cillian64/thegrid/hardware/README.md

# The·Grid Hardware

PCB designs for the power switching boards, the pole boards, and the bus driver 
board.
