cillian64/thegrid/website/content/blog/sticky.md

Date: 2014-07-05
Title: Welcome
Pin: true

The·Grid is an art/engineering installation to be displayed at 
[EMF](http://www.emfcamp.org) 2014 and 2016.  Visit the
[About]({filename}/pages/about.md) page for a quick overview of what we're
doing, or read the build log below for progress updates and juicy details...
