cillian64/thegrid/website/content/blog/2014-08-15.md

Title: Busy
Author: David
Tags: Electronics, cable, lasers

I've been extraordinarily busy!  First, I've finished filling all the PCBs,
shown here in the flight case with my Arduino Leonardo clone, the spare PCB and
the prototype PCB:

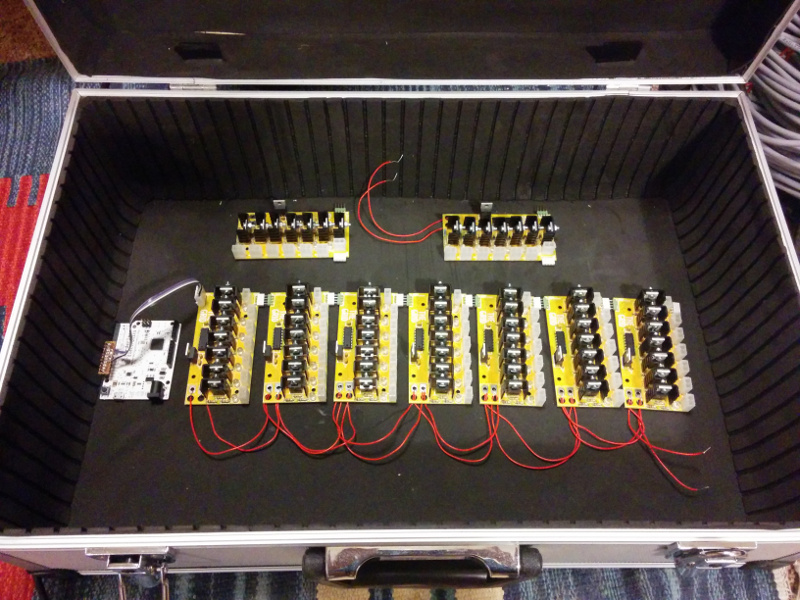
[picture p8: website/content/images/pcbs.jpg]
pcbs


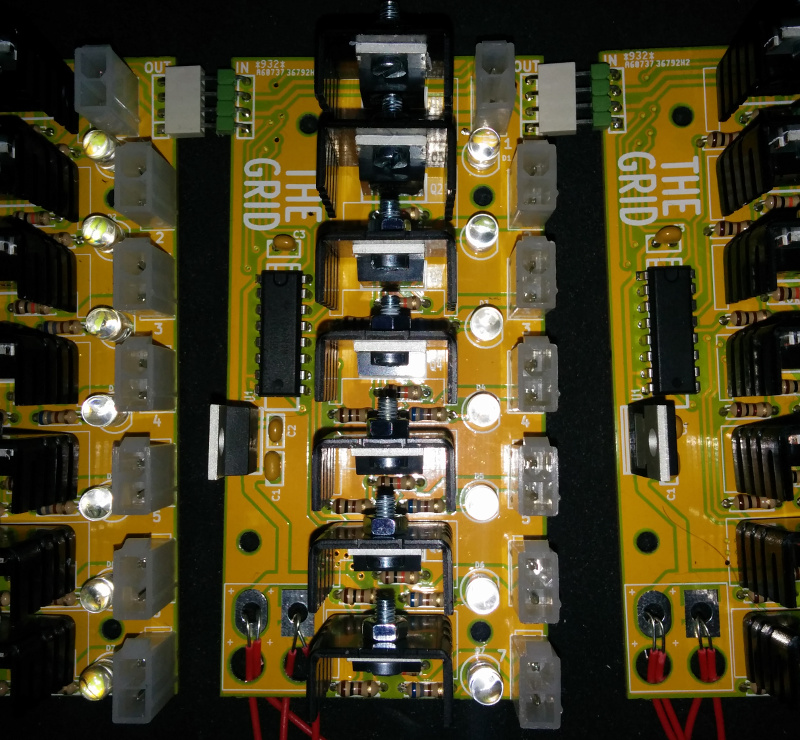
[picture p9: website/content/images/pcb.jpg]
pcb


More recently, I laser cut some beautiful rings to assist with guying of the
camera mast:

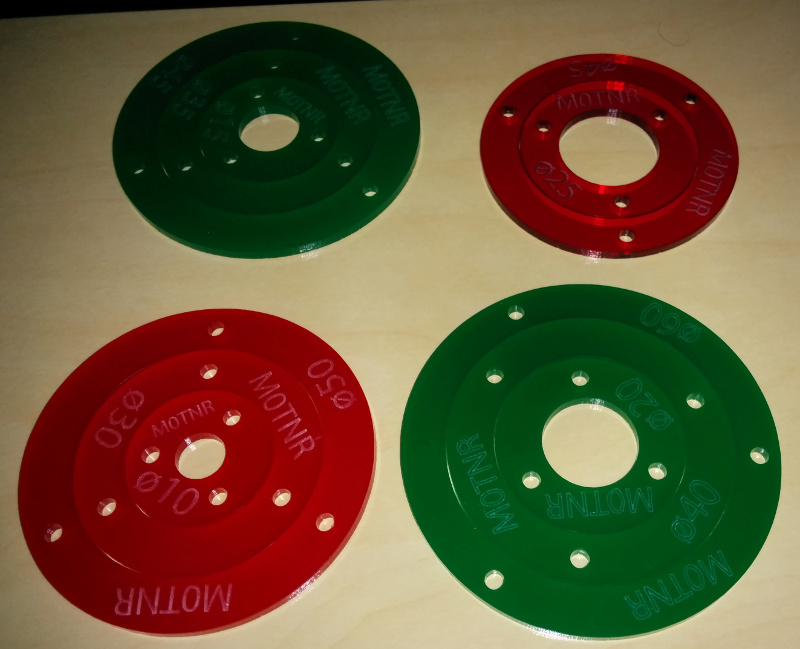
[picture p10: website/content/images/guying_rings.jpg]
guying rings


I also finished cutting all the cable into correct lengths:

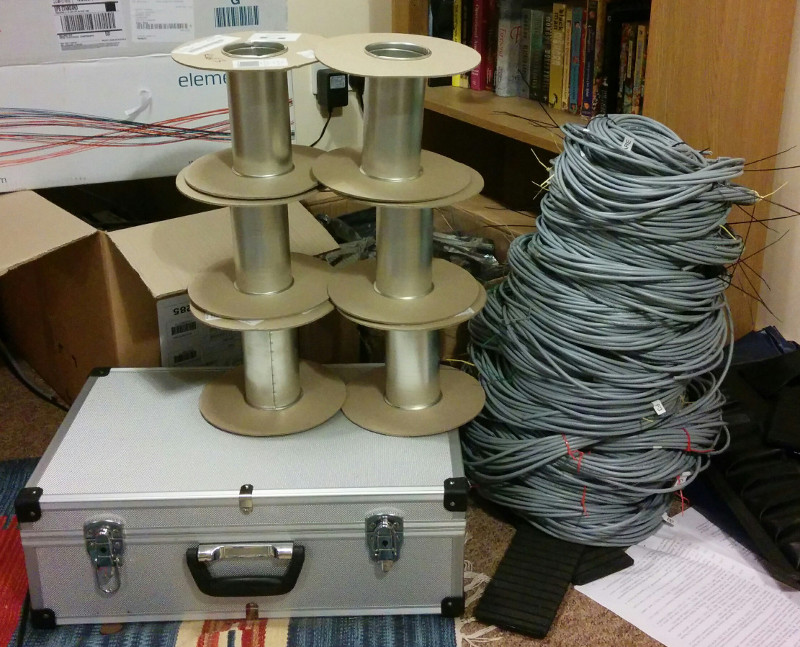
[picture p11: website/content/images/lots_cable.jpg]
lots of cable


Hopefully tomorrow we'll be getting started on the computer vision code...
