cillian64/thegrid/website/content/blog/2014-08-04.md

Title: Wire Delivery
Date: 2014-08-04
Author: Adam
Tags: electronics

Today we got the rest of the PCB components, the flight case that will house
the electronics, and the first 400m of field cable from CPC:

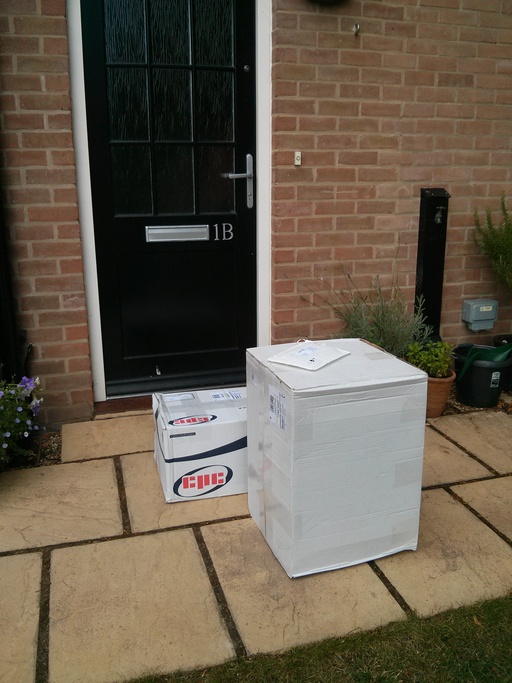
[picture p13: website/content/images/wire_delivery.jpg]
wire delivery


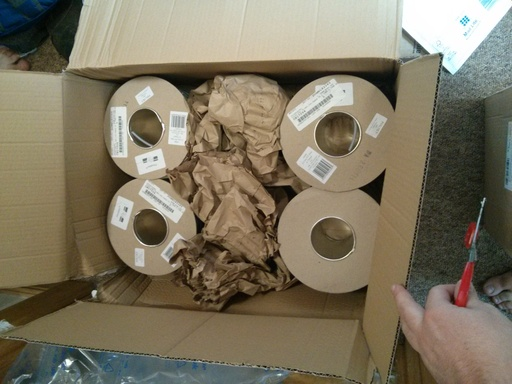
[picture p14: website/content/images/wire_spools.jpg]
wire spools


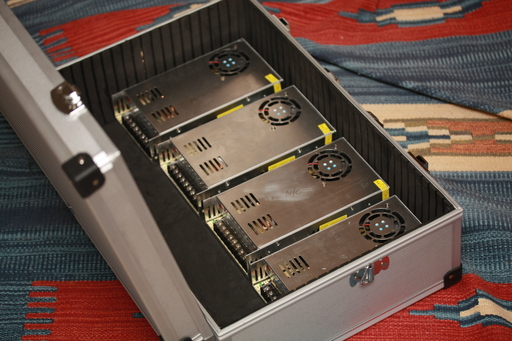
[picture p15: website/content/images/psus_in_case_mock.jpg]
psus in flight case


Looking good! We'll get the rest of the PCBs soldered up over the next few days
and then all that's left is a little mechanical work and a lot of careful
software.
