cillian64/thegrid/website/content/blog/2014-07-25.md

Title: PCBs!!!
Date: 2014-07-25
Tags: Electronics
Author: David

The PCBs arrived!  They are looking beautiful in yellow silk with shiny HASL
finish.  Considering how much Dirty PCBs downplay their quality, these boards
are excellent.  I can't fault anything on the copper, and the soldermask looks
great.  Registration isn't amazing on the drill hits and silk, but it's still
very good.  The silk is iffy in places, but that was expected.  Now all we have
to do is wait for the full complement of components.

Thanks to [Dirty PCBs](http://dirtypcbs.com/) for excellent service and
excellent boards -- we'll be back for our next project!

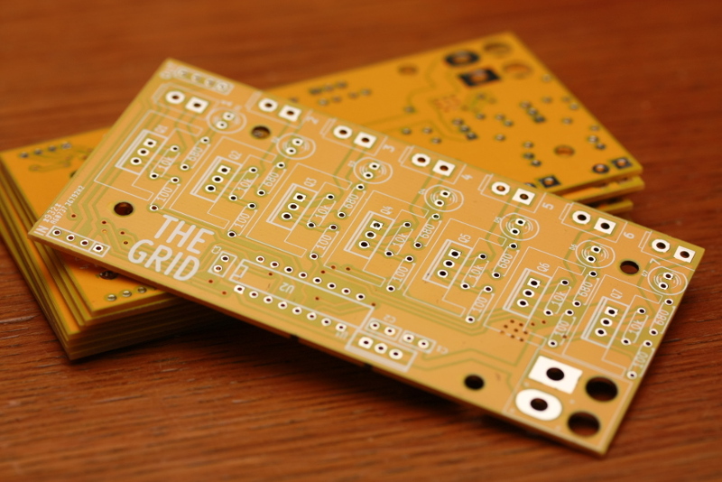
[picture p21: website/content/images/pcb_stack.jpg]
pcb stack


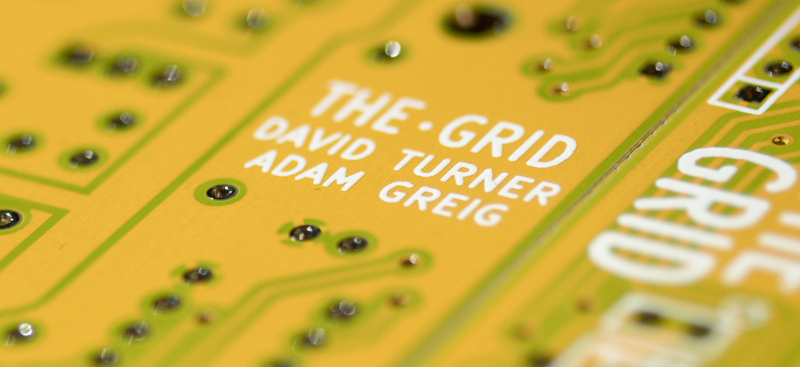
[picture p22: website/content/images/pcb_silk.jpg]
pcb silk


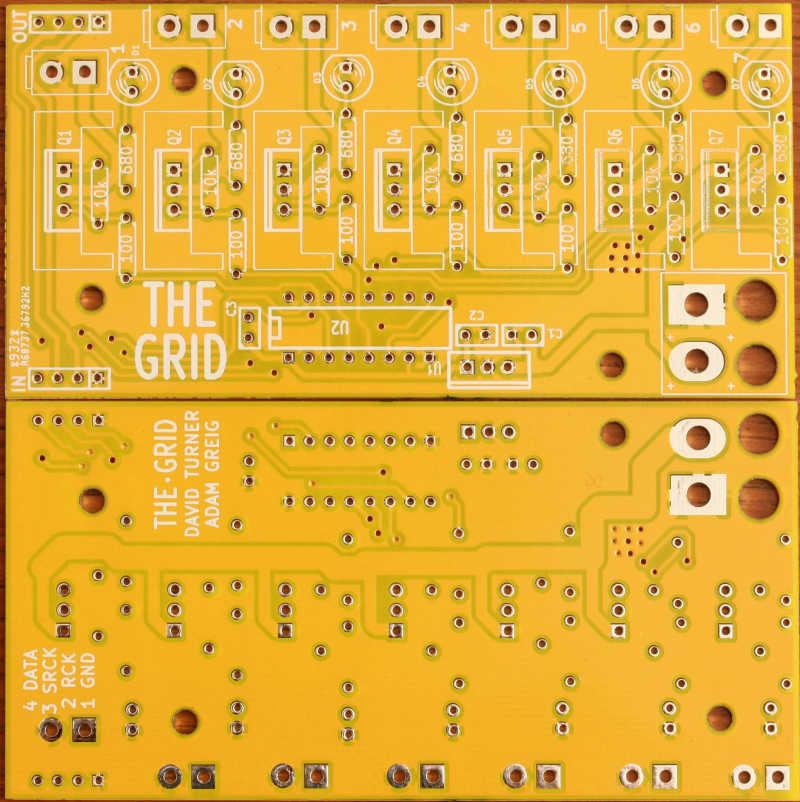
[picture p23: website/content/images/pcb_two.png]
pcb clear
