cillian64/thegrid/website/content/blog/2014-07-16-2.md

Title: Yellow PCB
Author: David
Tags: Electronics

I'm really excited about the PCBs, but don't really have much to report.
They're with fab house and should be manufactured by the beginning of next week
and with us by the end of next week.  Before they went to fab, I made a few
minor changes, mainly to increase clearance and track width.  This should make
the board pretty hard to get wrong, meaning we get a good yield.

Here are the updated gerbers, rendered by [Dirty PCBs](http://dirtypcbs.com/)
in a rendition of their final yellow soldermask:

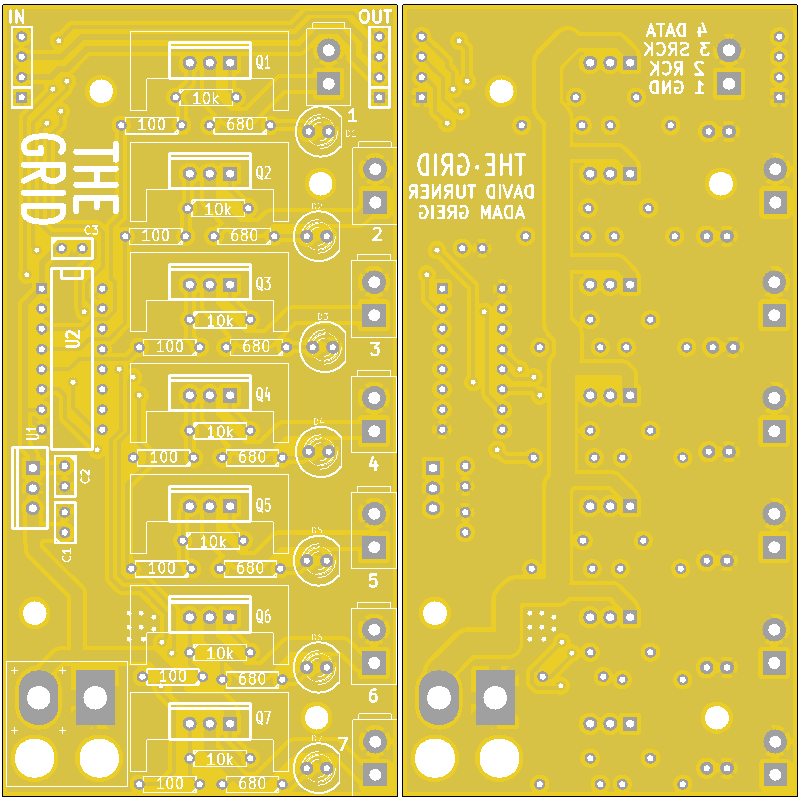
[picture p24: website/content/images/pcb_yellow.png]
yellow pcbs
