cillian64/thegrid/website/content/blog/2014-07-13.md

Title: Testing Intensifies
Tags: electronics, software
Date: 2014-07-13
Author: Adam

Another busy day. Further software refinements led to a Tkinter-based sink to
make visualisation easier:

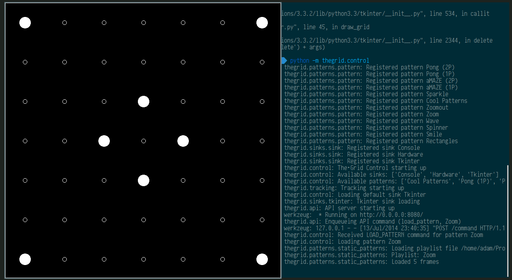
[picture p25: website/content/images/tkinter.png]
Tkinter GUI


I also stuck together a simple sink using pylibftdi in bitbang mode, which was
even easier than I expected. It generates the DATA, SRCK and RCK signals for
the shift registers using three pins on the FTDI.

Meanwhile David was busy finishing up the PCB design (more on that later).
Afterwards he stuck together the prototype electronics on a breadboard,
connected up the relays and two (of the eventual 49) LED strips and we tried
hooking it all up for the first time.

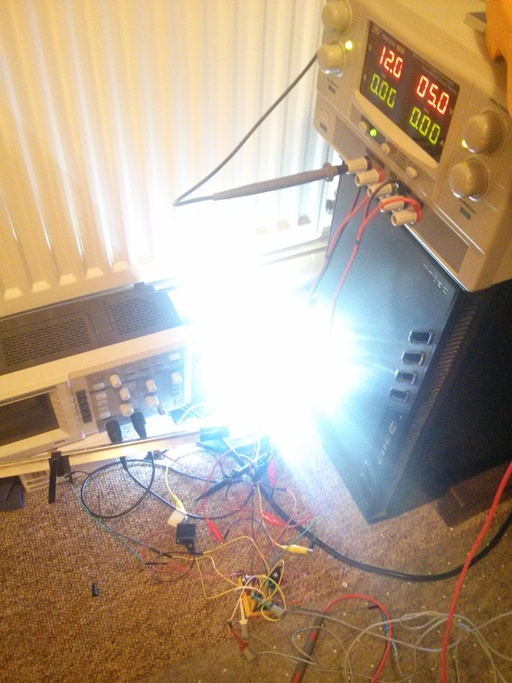
[picture p26: website/content/images/first_full_test.jpg]
First Full Test

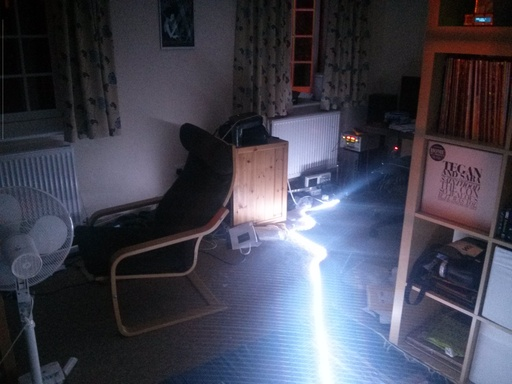
[picture p27: website/content/images/full_test_unrolled.jpg]
Full Test Unrolled


<iframe width="420" height="315"
src="//www.youtube-nocookie.com/embed/3Ok0Z6Nax6U?rel=0" frameborder="0"
allowfullscreen></iframe>

It all worked! Additionally the relays sounded great on one of the aluminium
poles. This is a very positive result and we're now confident that the
electronics design, software design, and various other choices that led to this
moment were at least on the right track.  All that's left is the actual PCBs,
the hard parts of the software (person tracking!) and a million other
tasks-to-do before EMF.
