cillian64/thegrid/website/content/blog/2014-07-13_2.md

Title: Gerbils away!
Date: 2014-07-13
Tags: Electronics
Author: David

After a final slog, the PCB was routed and ready to go!  Less than 48 hours
from deciding to do a PCB to submitting Gerbers has got to be a record.

I'll try to talk some more about some of the design choices when I've had more
sleep.  For now, here's what it looks like:

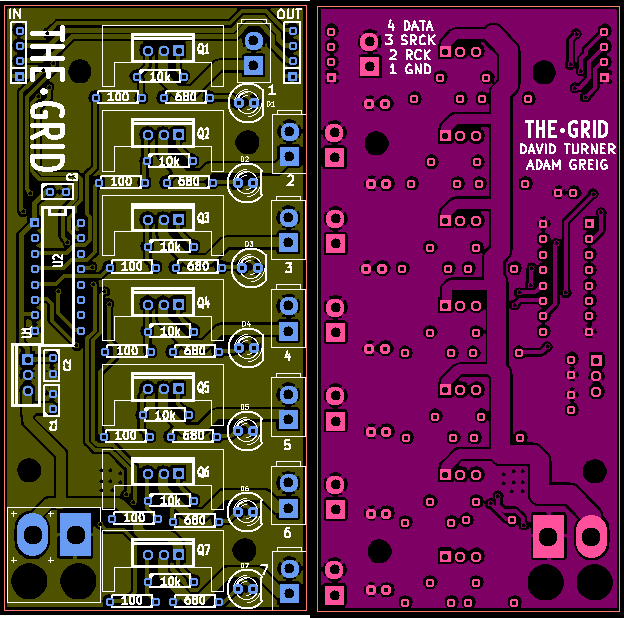
[picture p28: website/content/images/gerbils.png]
Gerbils...


And now, their fate rests in the trustworthy hands of [Dirty
PCBs](http://dirtypcbs.com/)...

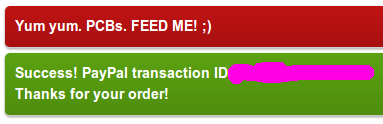
[picture p29: website/content/images/yum_yum_pcbs.png]
Ruh roh
