cillian64/thegrid/website/content/blog/2014-07-16.md

Title: LEDs Arrived!
Author: Adam
Date: 2014-07-16
Tags: LEDs

The LEDs turned up! £300, 250m, 7500 LEDs, in one unassuming box:

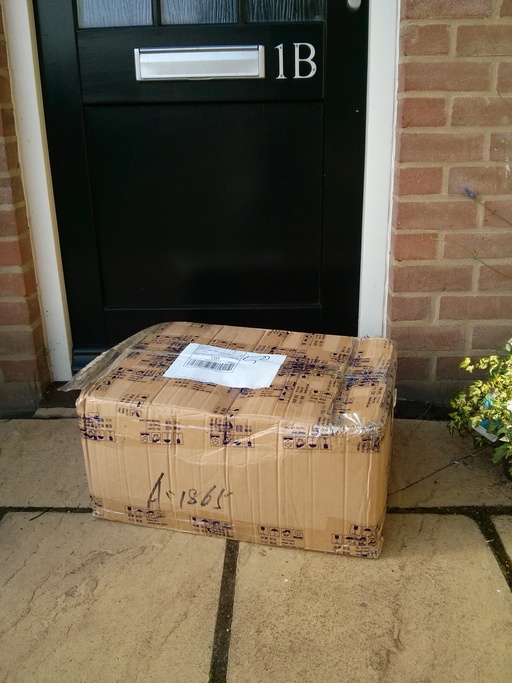
[picture p30: website/content/images/led_parcel.jpg]
LED parcel


We opened it up, and sure enough, 50 individually bagged reels of 5m LED strip:

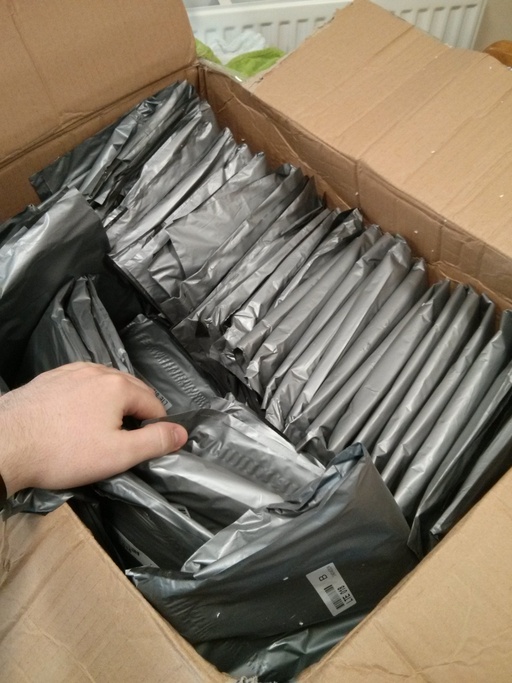
[picture p31: website/content/images/led_opened.jpg]
LED strips


Obviously we had to test all 50 to be sure they were in fine working order, so
we sat down and got to it.

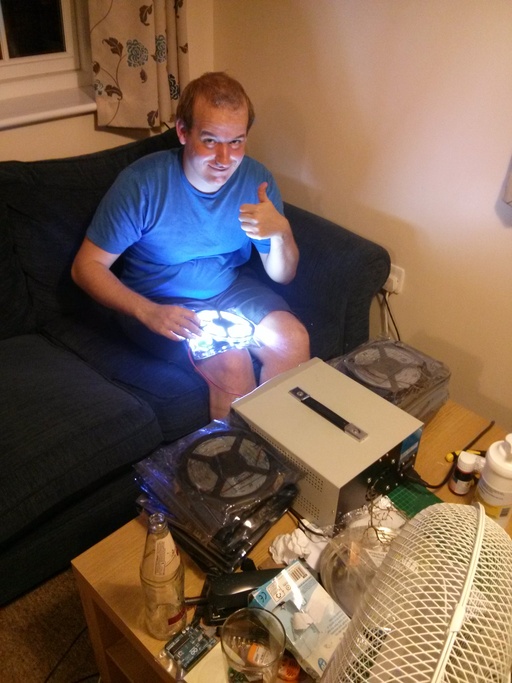
[picture p32: website/content/images/led_testing.jpg]
LED testing


I'm happy to report that every LED functioned correctly. Hurray!
