cillian64/thegrid/website/content/blog/2014-07-11.md

Title: Testing LED strips and a PSU
Tags: electronics, power, testing
Author: David
Date: 2014-07-11

I received a lot of parcels today!  The LEDs, thermal compound, some relays,
and what we have affectionately termed The Danger Cable:

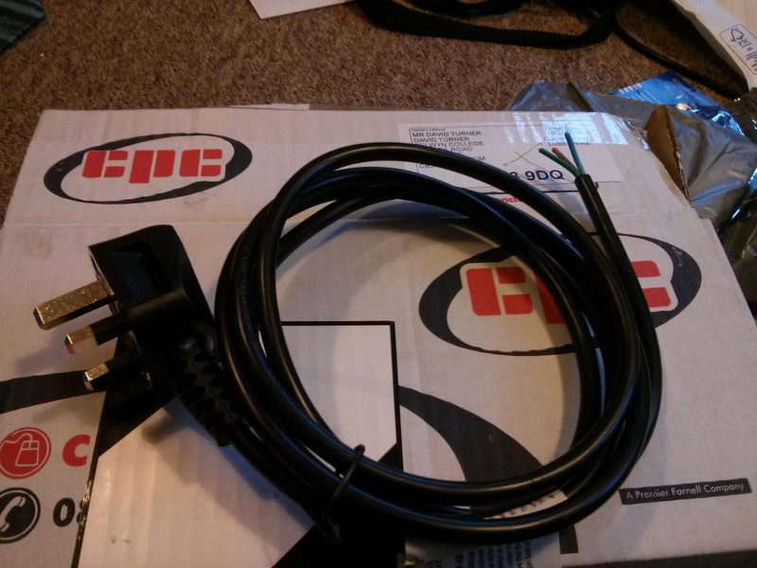
[picture p33: website/content/images/danger_cable.jpg]
schematic


At first we weren't convinced the LED strips would be bright enough.  A quick
test in the garden cleared any doubts about the brightness:

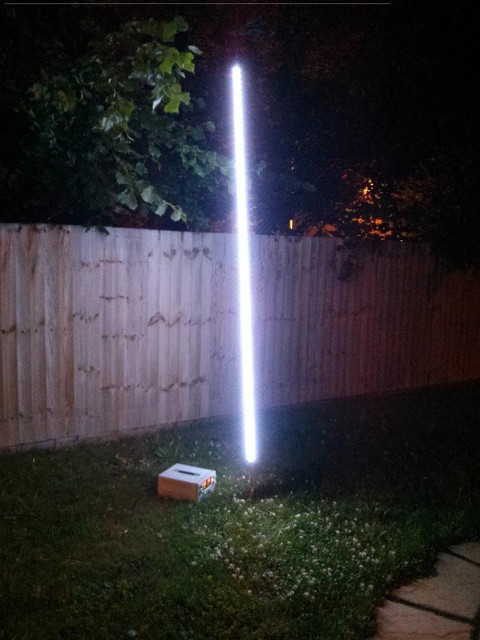
[picture p34: website/content/images/lightsabre.jpg]
lightsabre


Finally, I finished putting the power supply back together after a good clean
and a fresh dab of thermal grease.  After a little sanity testing, we thought
we'd give it some load:

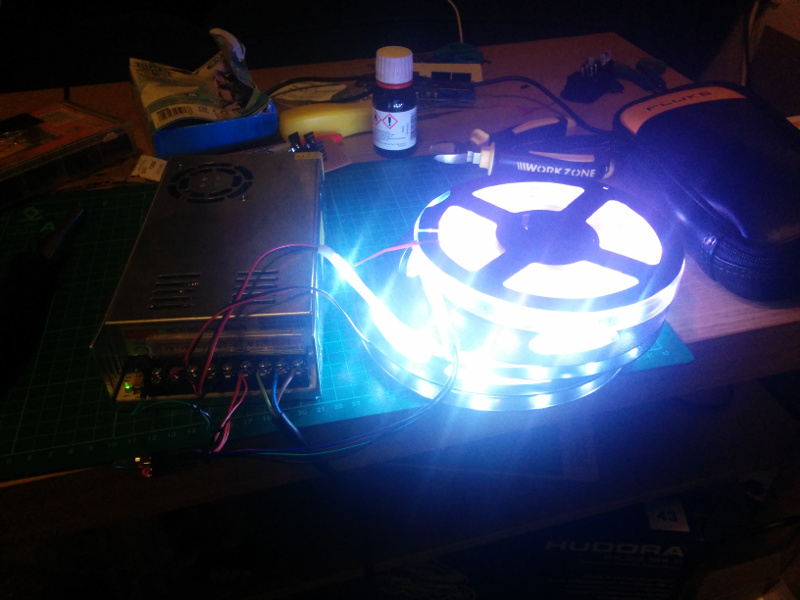
[picture p35: website/content/images/psu_test.jpg]
power supply testing


The power supply seems to work beautifully, although it was only pushing 4A out
of its rated 30A!
