cillian64/thegrid/website/content/blog/2014-07-09.md

Title: Aluminium Arrived (at last)
Tags: structures, power
Author: Adam
Date: 2014-07-09

After some more wrangling with the online vehicle tracking, we eventually had a
firm ETA... in the past. It slipped slowly further back in time until the
estimated delivery was an hour ago.

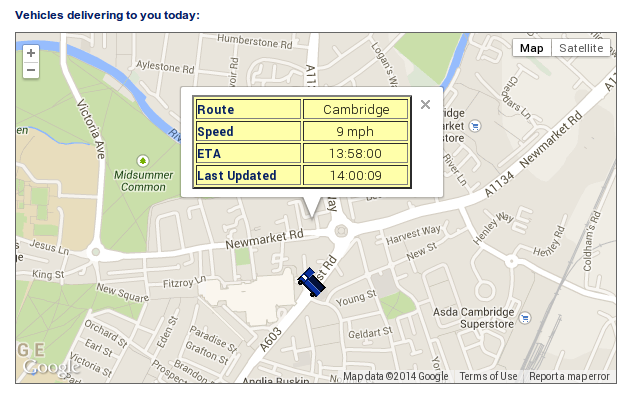
[picture p39: website/content/images/eta_the_past.png]
delivery tracking...


Luckily the aluminium did eventually make it to the present time and we happily
took delivery.

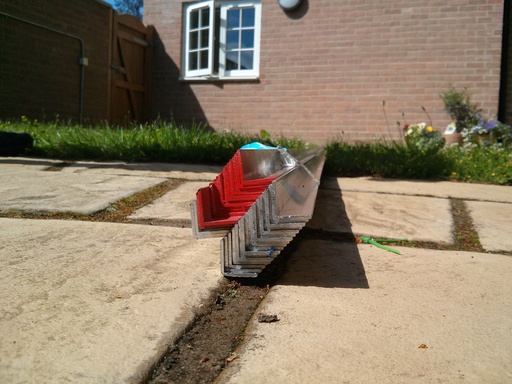
[picture p40: website/content/images/alu_in_garden.jpg]
aluminium in the garden


A few hours of hard sawing, filing and taping up later, and we now have eight
bundles of aluminium angle, all ready to be used for the structural component
of TheGrid.

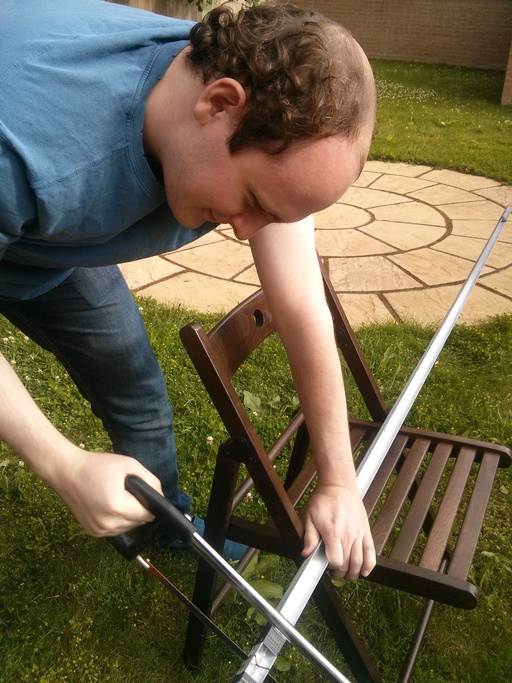
[picture p41: website/content/images/adam_sawing.jpg]
adam sawing


We also opened up one of the power supplies to investigate the design and
quality. True to the "Professional" sticker on the box, the insides included a
large toroid that had torn free of its soldering, so we'll probably need to do
a little rework before these are shipshape.

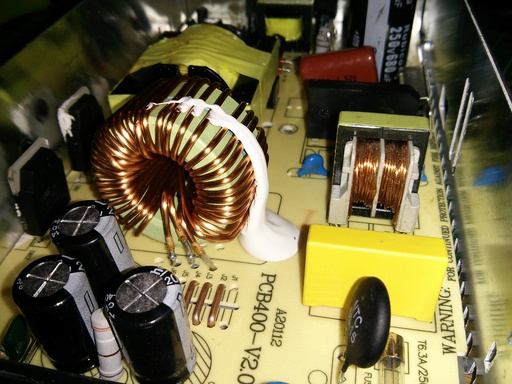
[picture p42: website/content/images/psu_dodgy_transformer.jpg]
i'm sure this PSU is just fine


The rest of the prototype electronics have also arrived, so we're ready to
start testing the control electronics. Hopefully the first LEDs (to verify
colour choice) will be arriving tomorrow so we can light something up!
