cillian64/thegrid/website/content/blog/2014-07-08.md

Title: PSUs arrived (aluminium didn't)
Tags: power
Date: 2014-07-08
Author: Adam

Five of the most legitimate 30A 12V PSUs you can find on eBay arrived today:
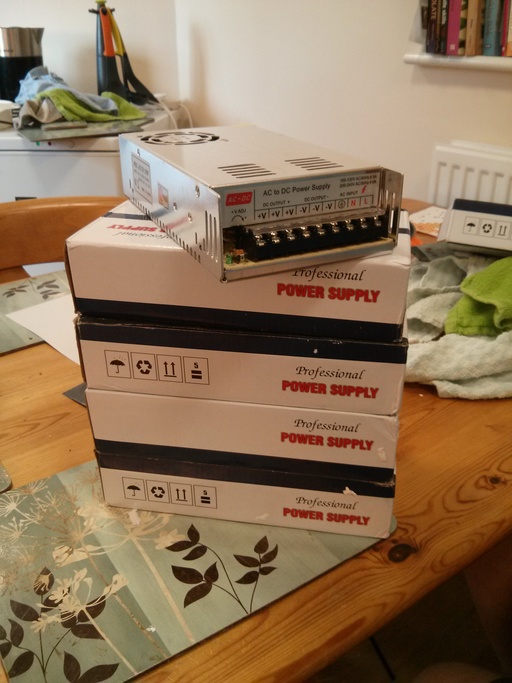
[picture p43: website/content/images/psus_arrived.jpg]
PSUs arrived


Unfortunately the aluminium couldn't be delivered today so fingers crossed
we'll get it tomorrow.
