cillian64/thegrid/website/content/blog/2014-07-05.md

Title: Approval!
Date: 2014-07-05
Author: David
Tags: power

We got approval!  We've been waiting for the EMF committee to get back to us
about our proposal, and, they did -- The·Grid at EMF2014 is happening!

To celebrate, I bought £70 worth of 12V PSUs (150A worth) and we set up this
website.
