cillian64/thegrid/misc/scripts/cutting_list.odt

--== CUTTING LIST ==--

THE.GRID 2

SERIAL CABLES

--- Reel 1 ---

9.2m [ ]

9.2m [ ]

9.2m [ ]

7.2m [ ]

7.2m [ ]

5.2m [ ]

5.2m [ ]

3.2m [ ]

3.2m [ ]

3.2m [ ]

3.2m [ ]

3.2m [ ]

3.2m [ ]

3.2m [ ]

3.2m [ ]

3.2m [ ]

3.2m [ ]

3.2m [ ]

3.2m [ ]

3.2m [ ]

3.2m [ ]

Leftover: 2.8m

Cable Tie Colours:

3.2m: purple

5.2m: yellow

7.2m: orange

9.2m: red

other/spare: black

--- Reel 2 ---

3.2m [ ]

3.2m [ ]

3.2m [ ]

3.2m [ ]

3.2m [ ]

3.2m [ ]

3.2m [ ]

3.2m [ ]

3.2m [ ]

3.2m [ ]

3.2m [ ]

3.2m [ ]

3.2m [ ]

3.2m [ ]

3.2m [ ]

3.2m [ ]

3.2m [ ]

3.2m [ ]

3.2m [ ]

3.2m [ ]

3.2m [ ]

3.2m [ ]

3.2m [ ]

3.2m [ ]

3.2m [ ]

3.2m [ ]

3.2m [ ]

3.2m [ ]

3.2m [ ]

3.2m [ ]

Leftover: 4.0m
