cillian64/thegrid/misc/docs/proposal/diags/plan.png

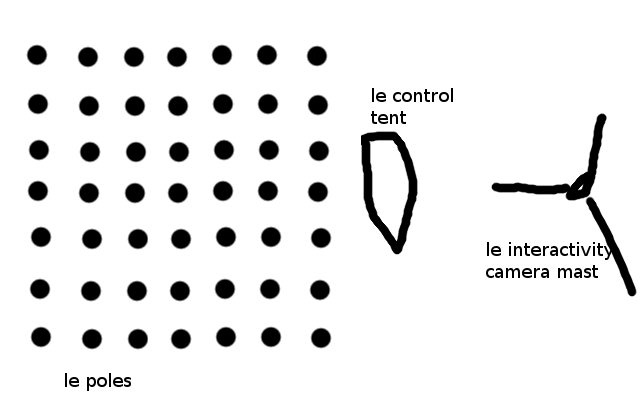
misc/docs/proposal/diags/plan.png
