cillian64/thegrid/misc/docs/proposal/diags/sidepole.png

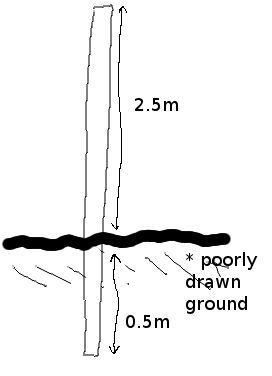
misc/docs/proposal/diags/sidepole.png
