cillian64/thegrid/misc/docs/proposal/diags/toppole.png

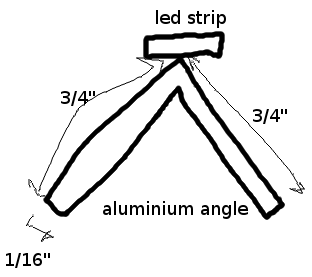
misc/docs/proposal/diags/toppole.png
