cillian64/thegrid/misc/docs/proposal_2/pics/thegrid_at_emf14_3.jpg

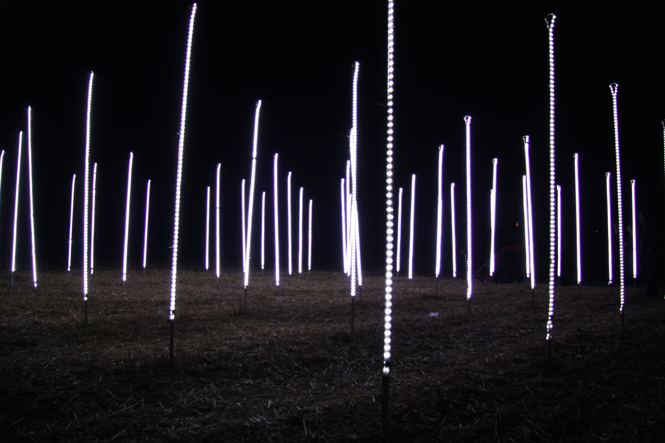
misc/docs/proposal_2/pics/thegrid_at_emf14_3.jpg
