cillian64/thegrid/misc/docs/farnell_parts.ods

Premier Farnell Sponsorship
Order # | Item | Quantity | Cost EA | Cost
1712122 | DURATOOL - TC-1 - ALUMINIUM TOOL CASE | 1 | £34.51 | 34.51
9846557 | FAIRCHILD SEMICONDUCTOR - FQP7P06 - MOSFET, P, TO-220 | 55 | £0.67 | 36.85
9339051 | MULTICOMP - MCF 0.25W 1K - RESISTOR, CARBON FILM, 1K, 0.25W, 5% | 50 | £0.02 | 1.05
1611415 | AAVID THERMALLOY - 507302B00000G - HEATSINK, TO-220, 24°C/W | 55 | £0.23 | 12.815
1470497 | TEXAS INSTRUMENTS - TPIC6C595N - IC, 8BIT SHIFT REGISTER | 10 | £1.33 | 13.3
2335729 | KINGBRIGHT - L-1503EC - LED, 5MM, RED, 50MCD, 617NM | 55 | £0.06 | 3.3
9338926 | MULTICOMP - MCF 0.5W 680R - RESISTOR, 0.5W 5% 680R | 50 | £0.02 | 0.85
1333039 | PRO POWER - 2192Y-0.75MMWHT100M - CABLE, FLEX, 2192Y, WHITE, 0.75MM, 100M | 6 | £32.58 | 195.48
1179199 | PRO POWER - 1179199 - WIRE, BK, BS6231, YELLOW, 6MM, 25M | 1 | £19.18 | 19.18
9423230 | MULTICOMP - N254-899 - STRIPBOARD, SNGL SIDED, 0.1INCH | 2 | £15.21 | 30.42
1892001 | TE CONNECTIVITY / OEG - SDT-S-112LMR,000 - RELAY, PCB, SPST-NO, 12VDC, 10A | 50 | £0.55 | 27.4
 |  |  | Sum: | 375.155
Us
Order # | Description | Quantity | Cost EA | Cost
TLTC1 | Flight Case | 1 | £18.85 | £18.85
SC08203 | FQP7P06 | 55 | £0.21 | £11.28
1611415 | Heatsinks | 50 | £0.17 | £8.37
1470497 | Shift Registers | 10 | £0.73 | £7.27
2335729 | LEDs | 55 | £0.04 | £2.26
CB17113 | Chunky PSU cable | 5 | £0.73 | £3.65
1892001 | Relays | 50 | £0.45 | £22.47
CN18792 | Crimp pins | 100 | £0.02 | £2.46
CN18767 | Connector receptacles | 50 | £0.06 | £2.87
CN18779 | Connector headers | 50 | £0.11 | £5.33
 |  |  | Sum: | £74.14
 |  |  | +VAT: | £88.96
Cable from Discount Electrical |  | 6 | £14.90 | £116.28
 |  | Grand Total: |  | £205.24
