cillian64/thegrid/hardware/pole/bom.ods

Farnell # | Q to order | Q per pole | Description | Q per 57 | Spare/bonus
1830747 | 120 | 2 | BUS_OUT BUS_IN | 114 | -4
9330399 | 130 | 2 | 10k 0603 | 114 | 16
2496930 | 70 | 1 | 4u7 0603 | 57 | 13
2296040 | 60 | 1 | LD1117DT33CTR TO-252-3 | 57 | 0
2393639 | 58 | 1 | STM32F0xxKxUx QFN-32-EP-ST | 57 | 1
9330410 | 70 | 1 | 1M 0603 | 57 | 13
2494233 | 70 | 1 | 10u 0603 | 57 | 13
2342314 | 60 | 1 | LMx93 SOIC-8 | 57 | 3
2284077 | 240 | 4 | MTM232270LBF SOT-323 | 228 | 12
2496916 | 70 | 1 | 1u 0603 | 57 | 13
2496826 | 70 | 1 | 10n 0603 | 57 | 13
2496833 | 250 | 4 | 100n 0603 | 228 | 22
1823866 | 60 | 1 | SPEAKER piezo | 57 | 3
2329477 | 10 | 0 | 120R 1/4W Termination | 0 | 10
1700251 | 70 | 1 | 10k for piezo bodge | 57 | 13
