cillian64/thegrid/misc/laser/signs/element14.dxf

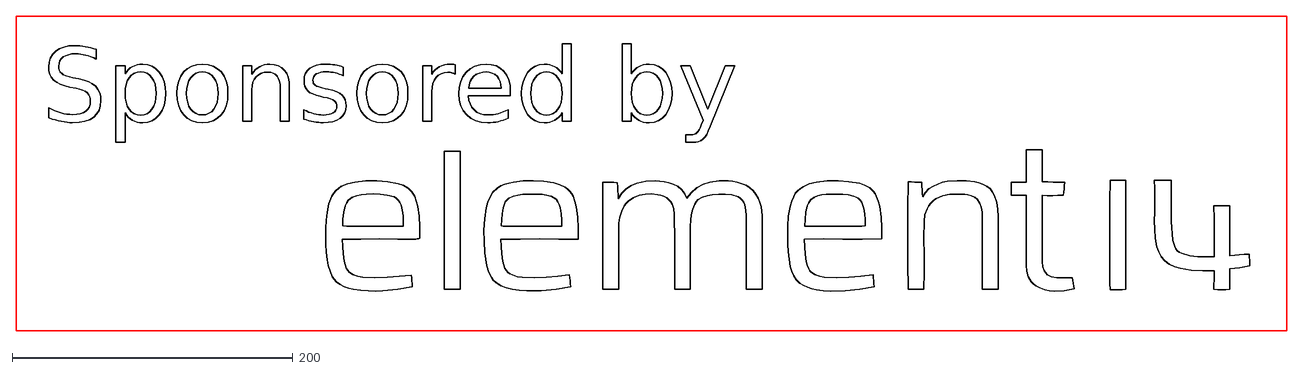
[picture p53: CAD file, 2014-08-26]
misc/laser/signs/element14.dxf
904.6 x 224.2
