cillian64/thegrid/misc/laser/guying_rings_stacked.dxf

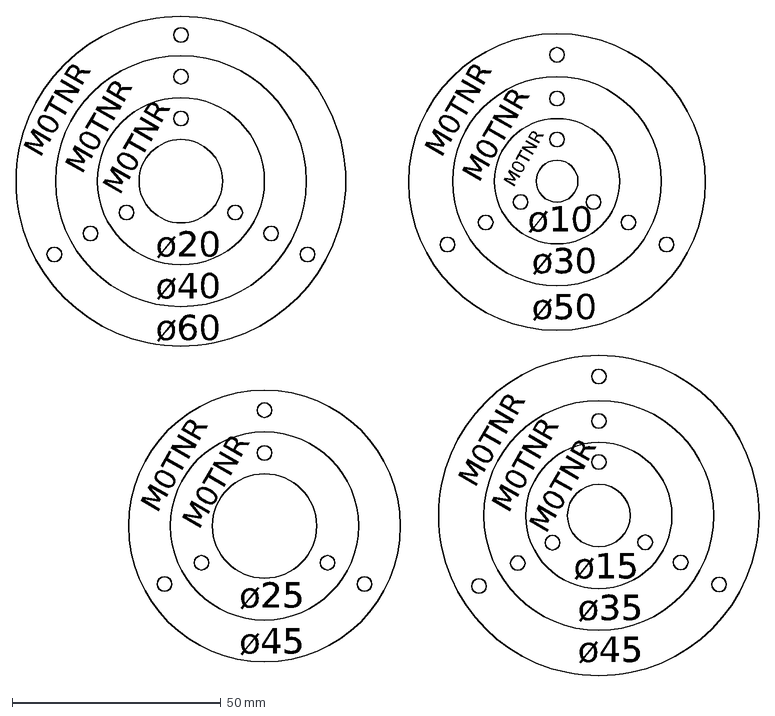
[picture p54: CAD file, 2014-08-16]
misc/laser/guying_rings_stacked.dxf
M0TNR
ø20
ø40
ø60
ø30
ø50
ø10
ø25
ø45
ø15
ø35
