cillian64/thegrid/misc/laser/signs/url.dxf

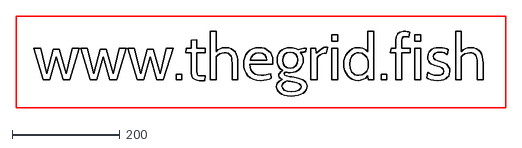
[picture p55: CAD file, 2014-08-26]
misc/laser/signs/url.dxf
906.6 x 169.6
