cillian64/thegrid/misc/laser/signs/both_signs_text_flattified.dxf

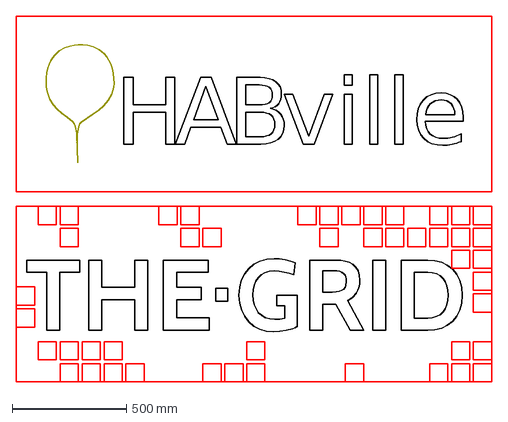
[picture p56: CAD file, 2014-08-22]
misc/laser/signs/both_signs_text_flattified.dxf
2080.0 x 1600.0 mm
