cillian64/thegrid/misc/laser/signs/noarduino.dxf

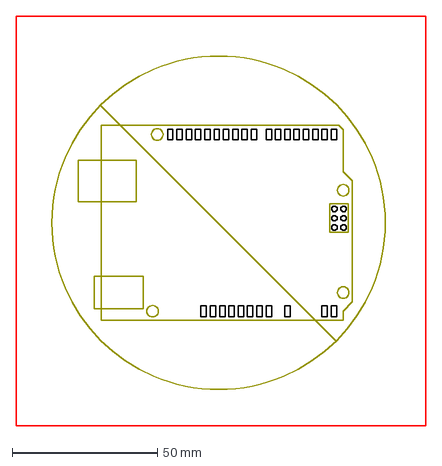
[picture p57: CAD file, 2014-08-22]
misc/laser/signs/noarduino.dxf
141.0 x 141.0 mm
