cillian64/thegrid/(list of files, cad)

Other CAD files:
misc/laser/all.dxf
