cillian64/thegrid/(threads)

Thread 16 (2016-04-13):

Manufacturing Checklist

adamgreig, 2016-04-13:
- [x] Make all serial cables
- [x] Make all power cables
- [x] Make all pole PCBs
- [x] Attach PCBs to LED strips

cillian64, 2016-04-13:
- [ ] make terminators

Closed 2019-11-08.

Thread 21 (2016-07-24):

Shield PCB r2

cillian64, 2016-07-24:
- [ ] Half the driver connectors are inverted relative to the part
 - [ ] Add an STM32F051 with USB instead of arduino shield
 - [ ] Bus drivers want a 5V supply, STM32 will want 3v3
