cillian64/thegrid/hardware/driver/shield_bom.pdf

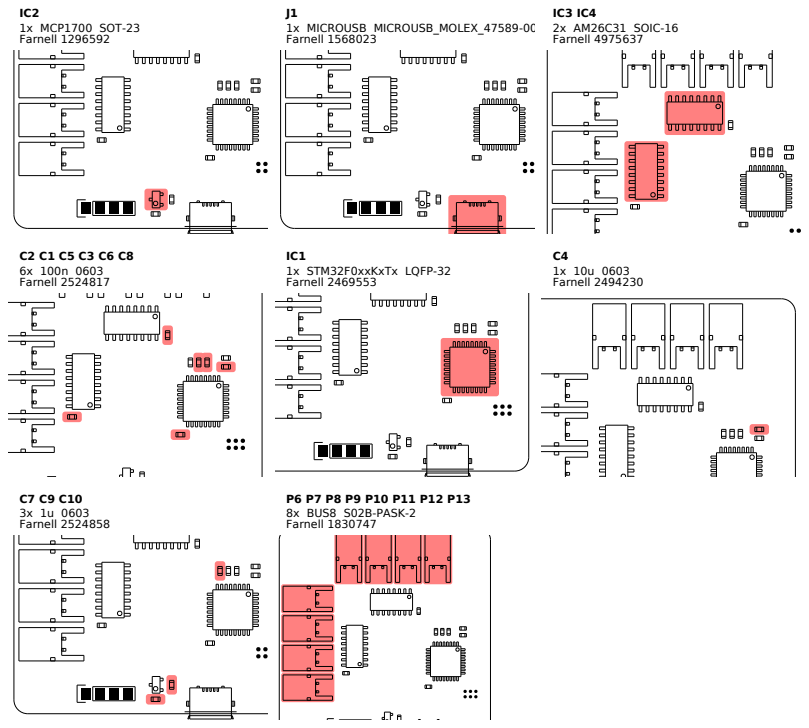
[picture p58: page 1]
