cillian64/thegrid/hardware/driver/shield.pdf

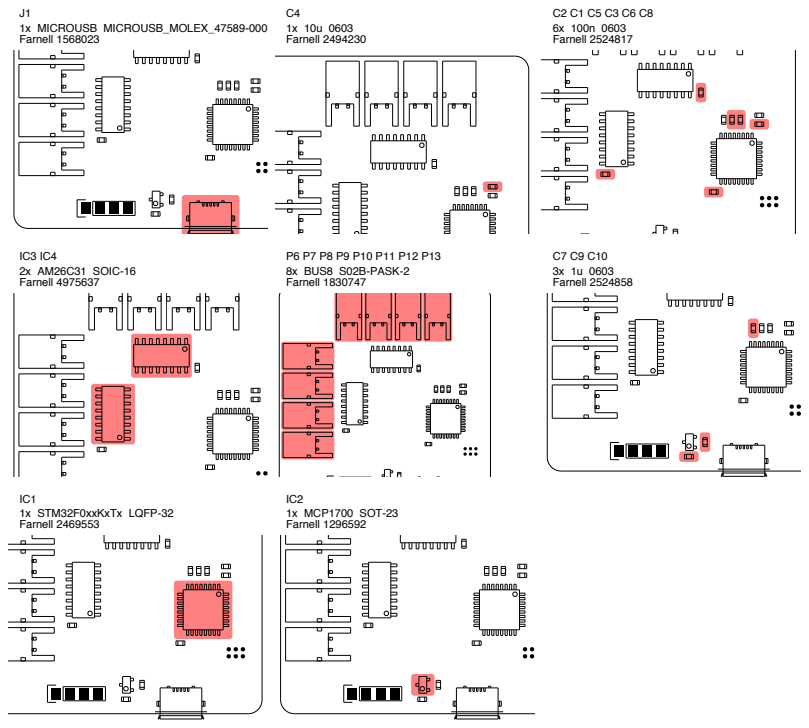
[picture p59: page 1]
