cillian64/thegrid/hardware/pole/pole.pdf

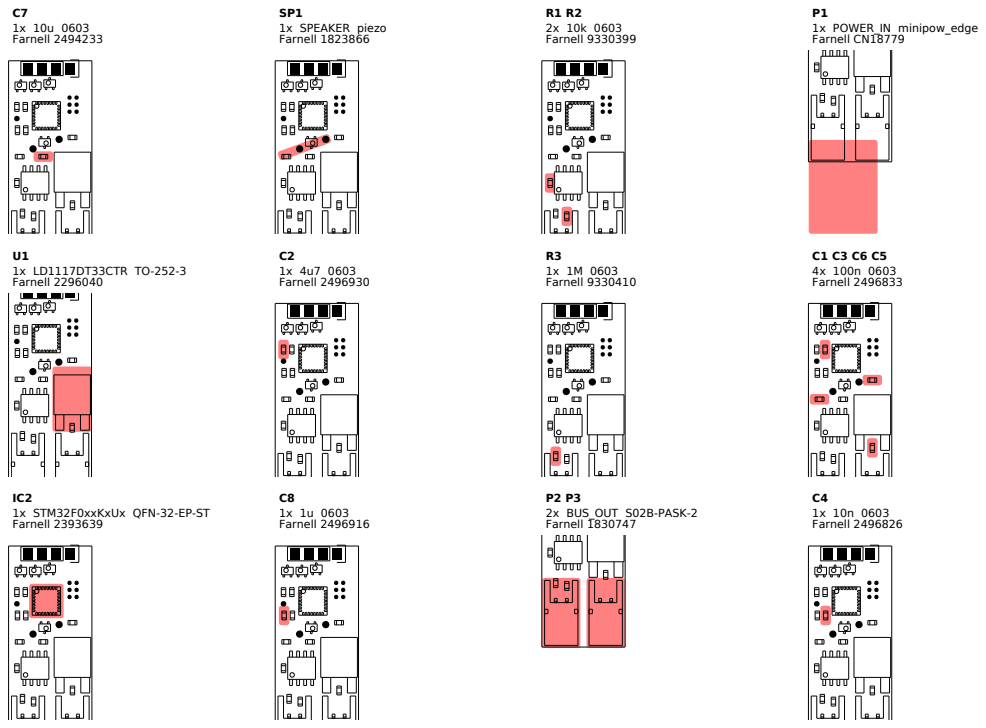
[picture p60: page 1]

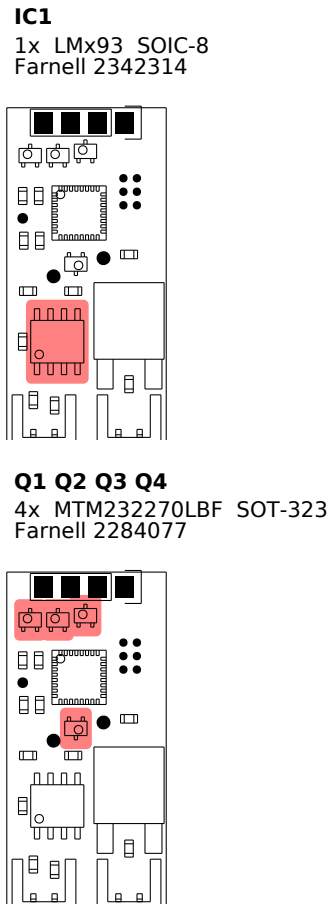
[picture p61: figure]
IC1 1x LMx93 SOIC-8 Farnell 2342314; Q1 Q2 Q3 Q4 4x MTM232270LBF SOT-323 Farnell 2284077
