cillian64/thegrid/hardware/driver/shield.kicad_pcb

## KiCad design hardware/driver/shield.kicad_pcb (2016-07-24)

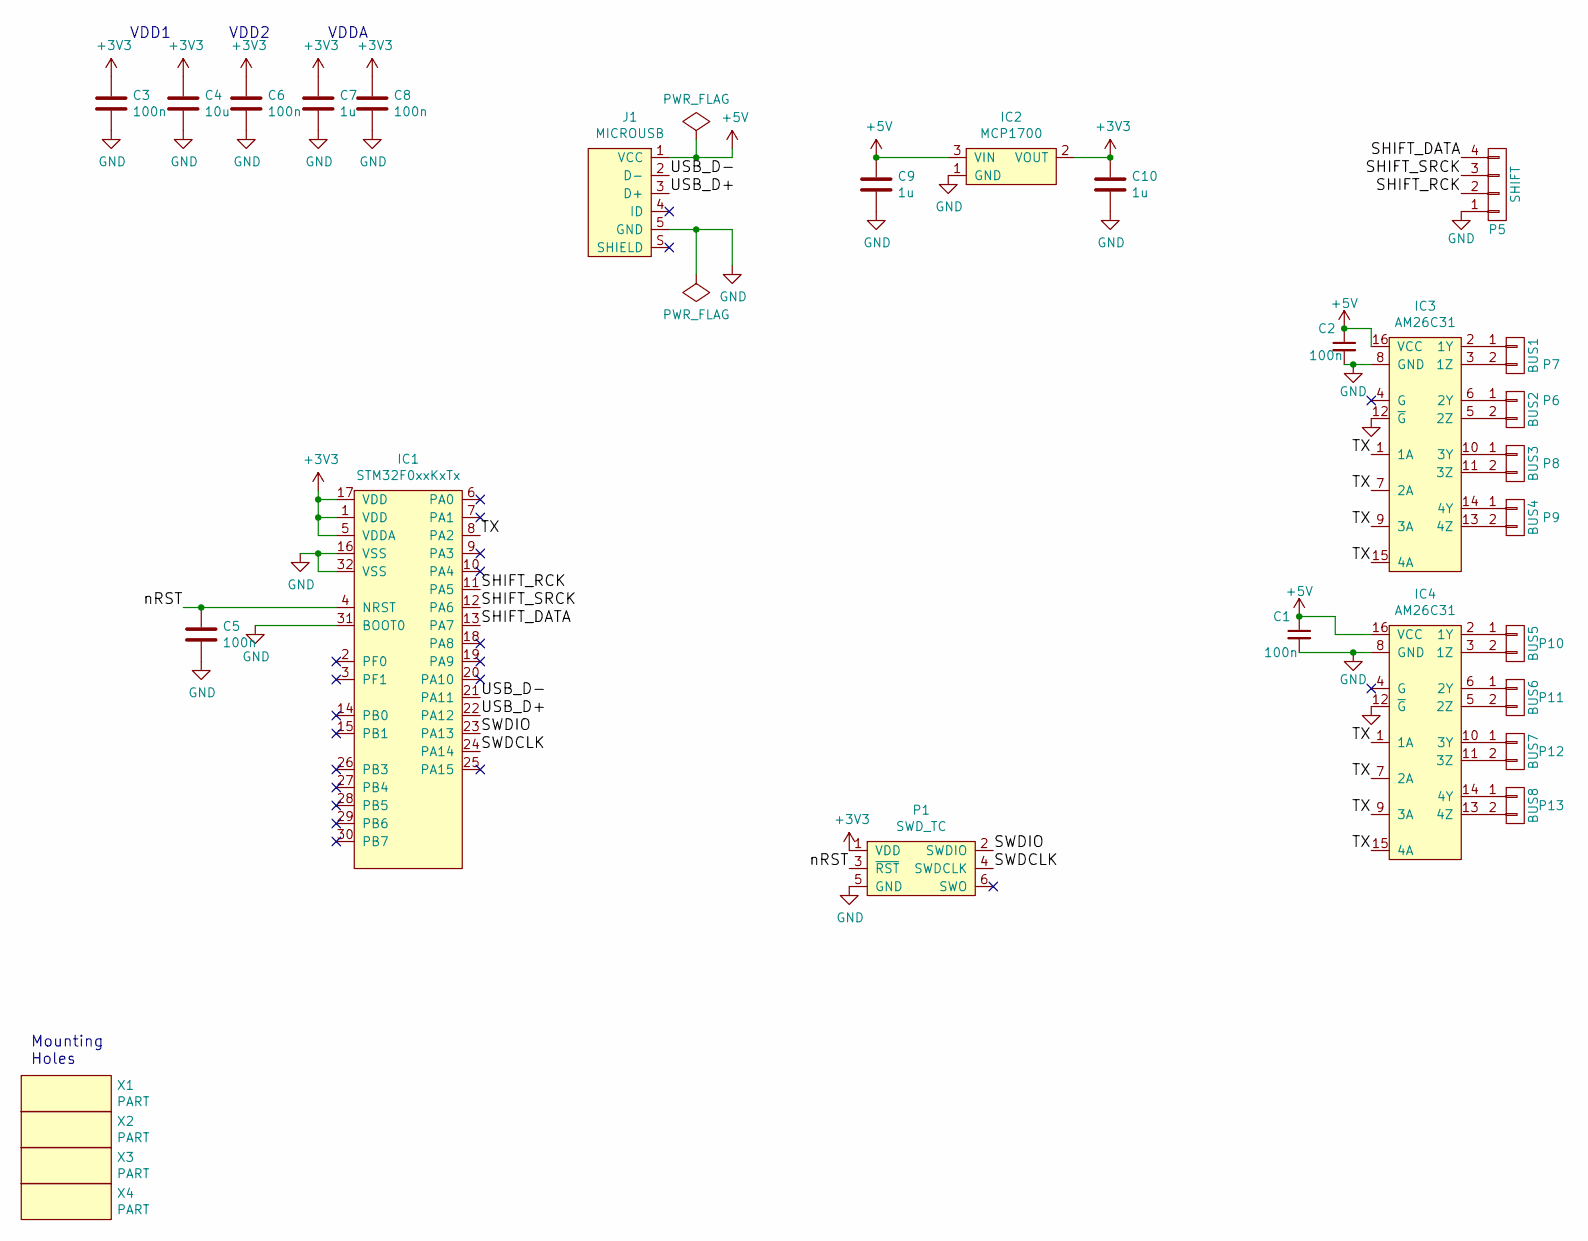
[picture p62: schematic shield.sch]

Parts:
C1, C2, C3, C5, C6, C8: 100n; 0603; Farnell 2524817
C4: 10u; 0603; Farnell 2494230
C7, C9, C10: 1u; 0603; Farnell 2524858
IC1: STM32F0xxKxTx; LQFP-32; Farnell 2469553
IC2: MCP1700; SOT-23; Farnell 1296592
IC3, IC4: AM26C31; SOIC-16; Farnell 4975637
J1: MICROUSB; MICROUSB_MOLEX_47589-0001; Farnell 1568023
P1: SWD_TC; TC2030-NL
P5: SHIFT; Pin_Header_Straight_1x04
P6: BUS1; S02B-PASK-2; Farnell 1830747
P7: BUS2; S02B-PASK-2; Farnell 1830747
P8: BUS3; S02B-PASK-2; Farnell 1830747
P9: BUS4; S02B-PASK-2; Farnell 1830747
P10: BUS5; S02B-PASK-2; Farnell 1830747
P11: BUS6; S02B-PASK-2; Farnell 1830747
P12: BUS7; S02B-PASK-2; Farnell 1830747
P13: BUS8; S02B-PASK-2; Farnell 1830747
X1, X2, X3, X4: PART; M3_MOUNT

Connections:
+3V3: C3.1, C4.1, C6.1, C7.1, C8.1, C10.1, IC1.1 (VDD), IC1.5 (VDDA), IC1.17 (VDD), IC2.2 (VOUT), P1.1 (VDD)
+5V: C1.1, C2.1, C9.1, IC2.3 (VIN), IC3.16 (VCC), IC4.16 (VCC), J1.1 (VCC)
/SHIFT_DATA: IC1.13 (PA7), P5.4
/SHIFT_RCK: IC1.11 (PA5), P5.2
/SHIFT_SRCK: IC1.12 (PA6), P5.3
/SWDCLK: IC1.24 (PA14), P1.4 (SWDCLK)
/SWDIO: IC1.23 (PA13), P1.2 (SWDIO)
/TX: IC1.8 (PA2), IC3.1 (1A), IC3.7 (2A), IC3.9 (3A), IC3.15 (4A), IC4.1 (1A), IC4.7 (2A), IC4.9 (3A), IC4.15 (4A)
/USB_D+: IC1.22 (PA12), J1.3 (D+)
/USB_D-: IC1.21 (PA11), J1.2 (D-)
/nRST: C5.1, IC1.4 (NRST), P1.3 (~RST)
GND: C1.2, C2.2, C3.2, C4.2, C5.2, C6.2, C7.2, C8.2, C9.2, C10.2, IC1.16 (VSS), IC1.31 (BOOT0), IC1.32 (VSS), IC2.1 (GND), IC3.8 (GND), IC3.12 (~G), IC4.8 (GND), IC4.12 (~G), J1.5 (GND), P1.5 (GND), P5.1
unnamed: IC3.2 (1Y), P6.1
unnamed: IC3.3 (1Z), P6.2
unnamed: IC3.5 (2Z), P7.2
unnamed: IC3.6 (2Y), P7.1
unnamed: IC3.10 (3Y), P8.1
unnamed: IC3.11 (3Z), P8.2
unnamed: IC3.13 (4Z), P9.2
unnamed: IC3.14 (4Y), P9.1
unnamed: IC4.2 (1Y), P10.1
unnamed: IC4.3 (1Z), P10.2
unnamed: IC4.5 (2Z), P11.2
unnamed: IC4.6 (2Y), P11.1
unnamed: IC4.10 (3Y), P12.1
unnamed: IC4.11 (3Z), P12.2
unnamed: IC4.13 (4Z), P13.2
unnamed: IC4.14 (4Y), P13.1

Notes on the sheet:
VDD1
VDD2
VDDA
Mounting Holes

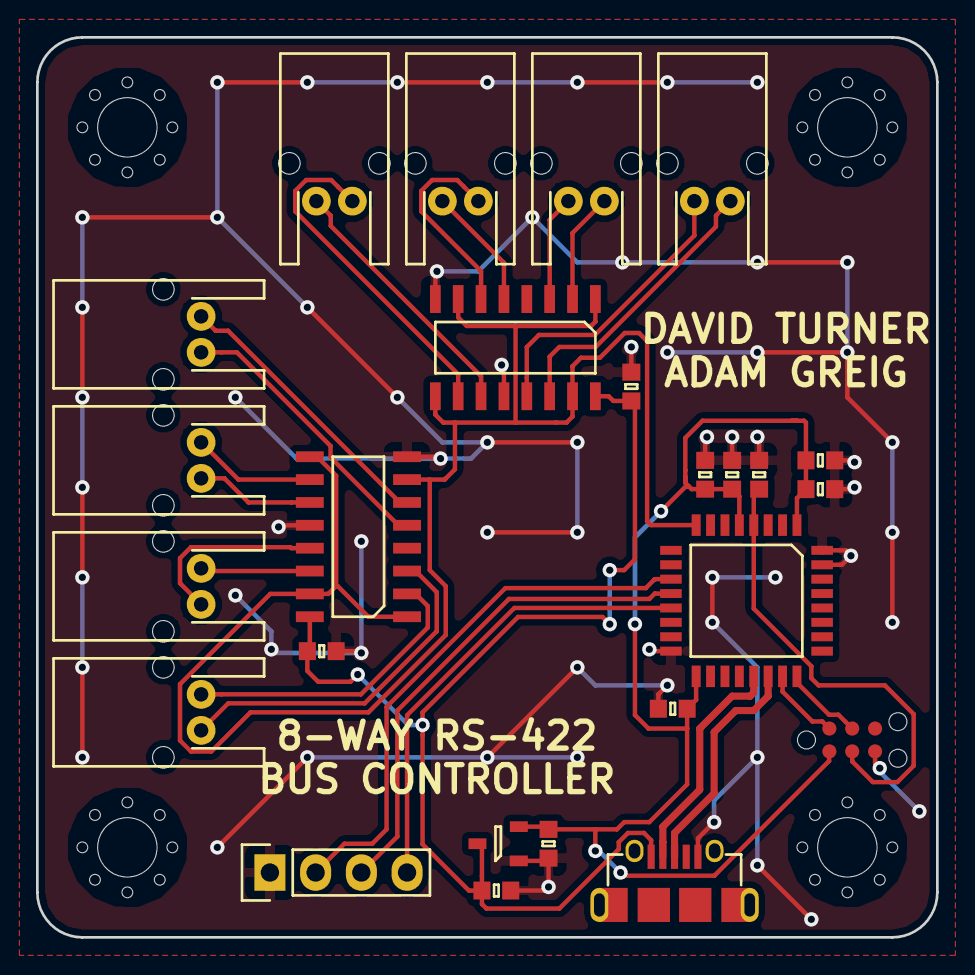
[picture p63: board shield.kicad_pcb from above]

Board: 2 copper layers, 50.0 x 50.0 mm, 29 parts (0 on the bottom side), 28 nets.
