cillian64/thegrid/hardware/pole/pole.kicad_pcb

## KiCad design hardware/pole/pole.kicad_pcb (2016-03-28)

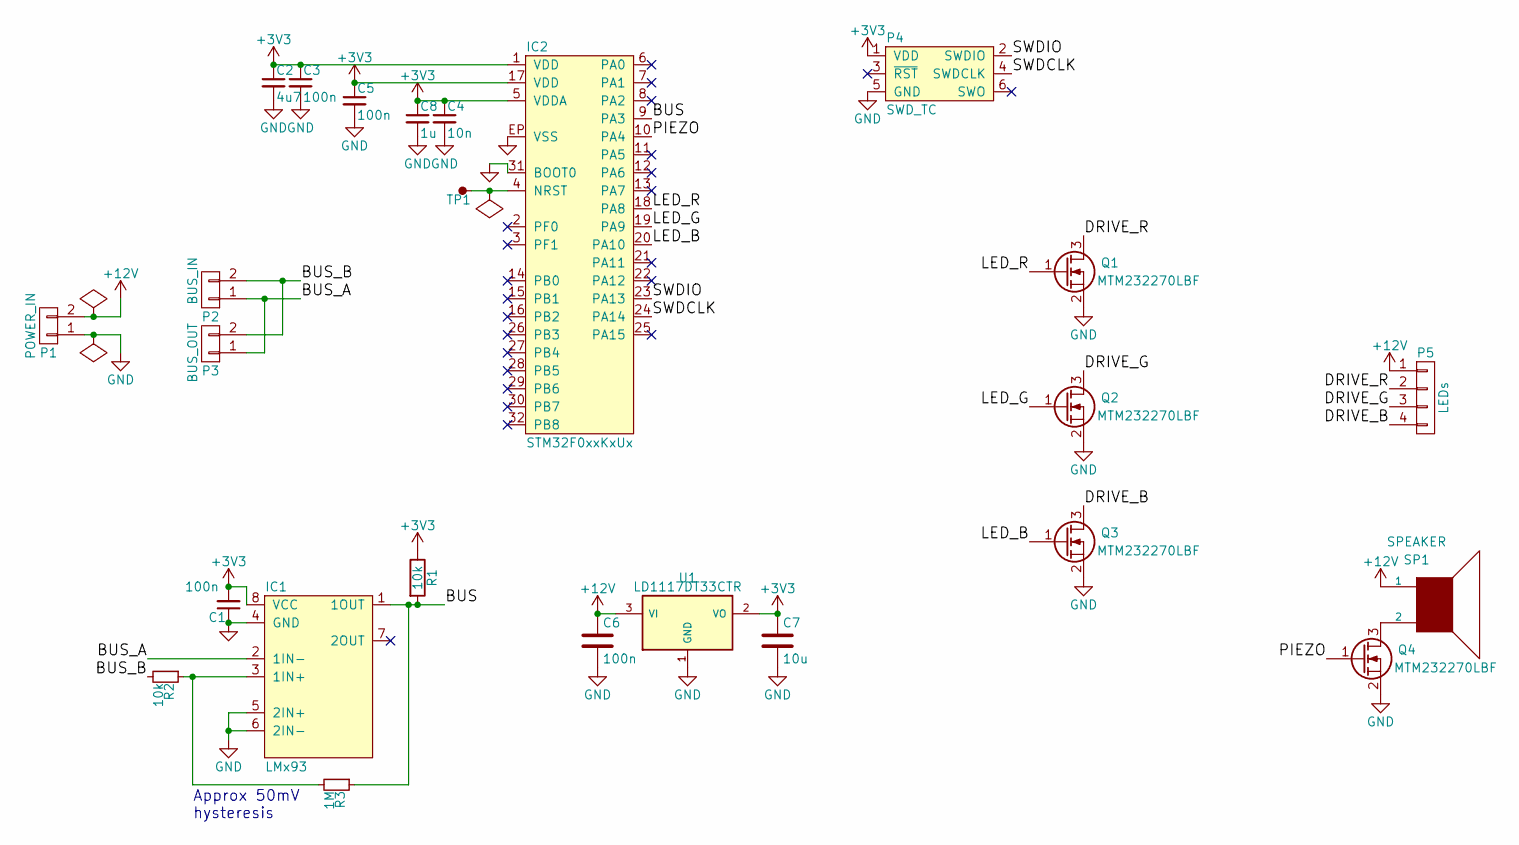
[picture p64: schematic pole.sch]

Parts:
C1, C3, C5, C6: 100n; 0603; Farnell 2496833
C2: 4u7; 0603; Farnell 2496930
C4: 10n; 0603; Farnell 2496826
C7: 10u; 0603; Farnell 2494233
C8: 1u; 0603; Farnell 2496916
IC1: LMx93; SOIC-8; Farnell 2342314
IC2: STM32F0xxKxUx; QFN-32-EP-ST; Farnell 2393639
P1: POWER_IN; minipow_edge; Farnell CN18779
P2: BUS_IN; S02B-PASK-2; Farnell 1830747
P3: BUS_OUT; S02B-PASK-2; Farnell 1830747
P4: SWD_TC; TC2030-NL
P5: LEDs; Pin_Header_Straight_1x04
Q1, Q2, Q3, Q4: MTM232270LBF; SOT-323; Farnell 2284077
R1, R2: 10k; 0603; Farnell 9330399
R3: 1M; 0603; Farnell 9330410
SP1: SPEAKER; piezo; Farnell 1823866
TP1: RST; TESTPAD
U1: LD1117DT33CTR; TO-252-3; Farnell 2296040

Connections:
+3V3: C1.2, C2.1, C3.1, C4.1, C5.1, C7.1, C8.1, IC1.8 (VCC), IC2.1 (VDD), IC2.5 (VDDA), IC2.17 (VDD), P4.1 (VDD), R1.1, U1.2 (VO)
+12V: C6.1, P1.2, P5.1, SP1.1, U1.3 (VI)
/BUS: IC1.1 (1OUT), IC2.9 (PA3), R1.2, R3.1
/BUS_A: IC1.2 (1IN-), P2.1, P3.1
/BUS_B: P2.2, P3.2, R2.2
/DRIVE_B: P5.4, Q3.3 (D)
/DRIVE_G: P5.3, Q2.3 (D)
/DRIVE_R: P5.2, Q1.3 (D)
/LED_B: IC2.20 (PA10), Q3.1 (G)
/LED_G: IC2.19 (PA9), Q2.1 (G)
/LED_R: IC2.18 (PA8), Q1.1 (G)
/PIEZO: IC2.10 (PA4), Q4.1 (G)
/SWDCLK: IC2.24 (PA14), P4.4 (SWDCLK)
/SWDIO: IC2.23 (PA13), P4.2 (SWDIO)
GND: C1.1, C2.2, C3.2, C4.2, C5.2, C6.2, C7.2, C8.2, IC1.4 (GND), IC1.5 (2IN+), IC1.6 (2IN-), IC2.31 (BOOT0), IC2.EP (VSS), P1.1, P4.5 (GND), Q1.2 (S), Q2.2 (S), Q3.2 (S), Q4.2 (S), U1.1 (GND)
unnamed: IC1.3 (1IN+), R2.1, R3.2
unnamed: IC2.4 (NRST), TP1.1
unnamed: Q4.3 (D), SP1.2

Notes on the sheet:
Approx 50mV hysteresis

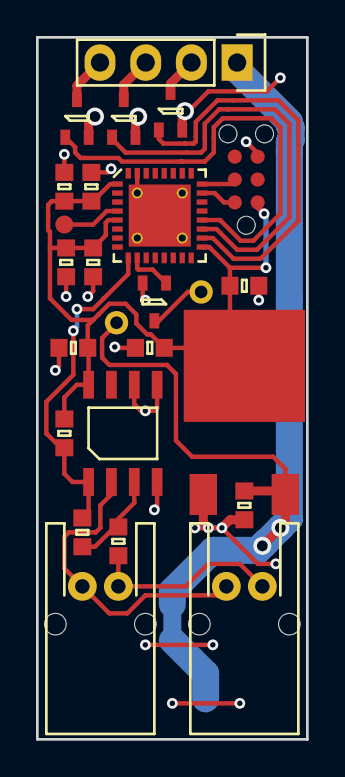
[picture p65: board pole.kicad_pcb from above]

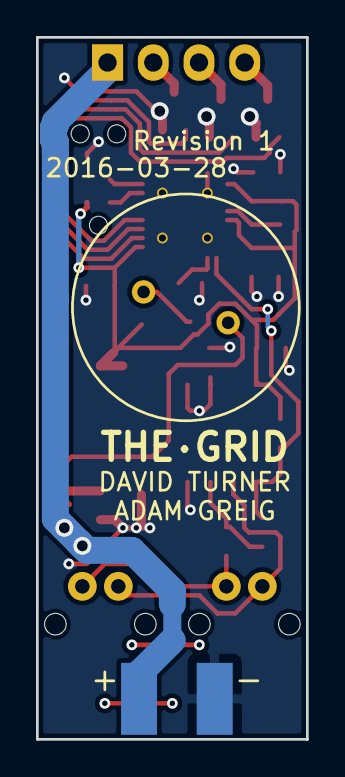
[picture p66: board pole.kicad_pcb from below]

Board: 2 copper layers, 15.0 x 39.0 mm, 25 parts (2 on the bottom side), 18 nets.
