cillian64/thegrid/hardware/power/thegrid.kicad_pcb

## KiCad design hardware/power/thegrid.kicad_pcb (2014-07-16)

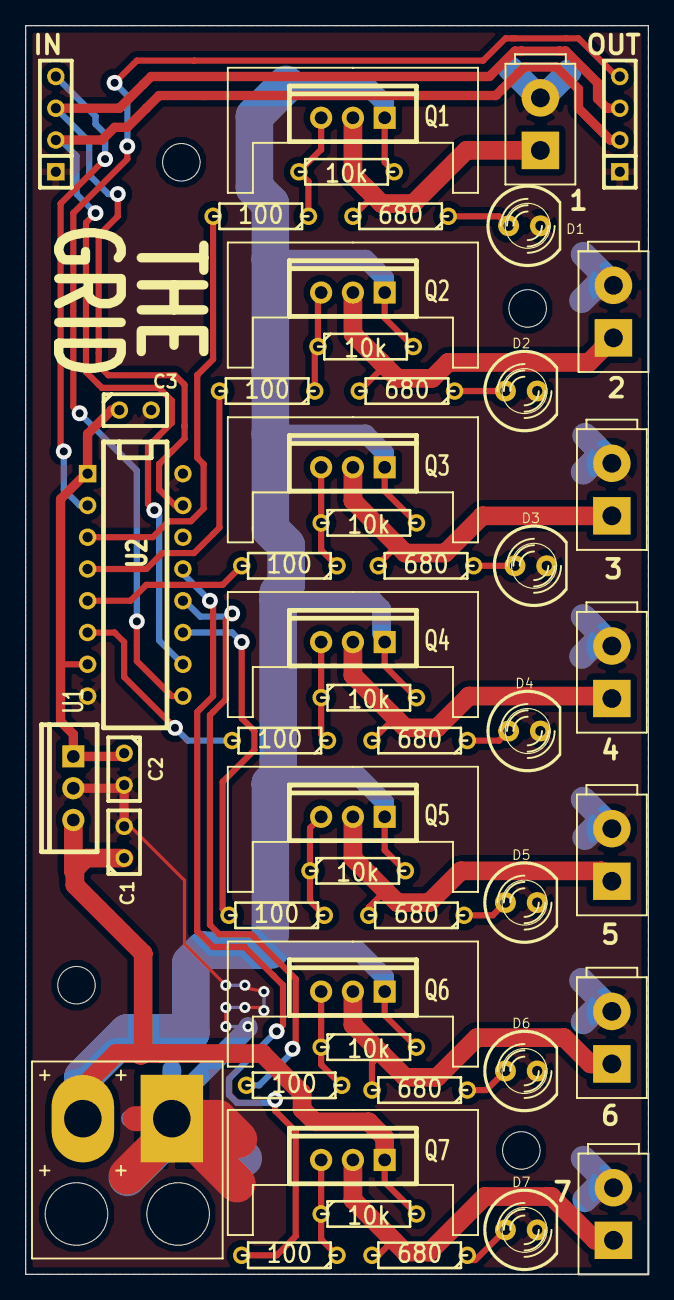
[picture p67: board thegrid.kicad_pcb from above]

Board: 2 copper layers, 49.8 x 99.8 mm, 54 parts (0 on the bottom side), 35 nets.

Parts:
C1: .33u; C1
C2: .1u; C1
C3: 100n; C1
D1, D2, D3, D4, D5, D6, D7: LED; LED-5MM
MH: MountingHole_3mm_RevA_Date21Jun2010; MountingHole_3mm
MH#2, MH#3, MH#4: MountingHole_3mm_RevA_Date21Jun2010; MountingHole_3mm
P1: POWER; SIL-2
P2: SHIFT_IN; SIL-4
P3: SHIFT_OUT; SIL-4
P4, P5, P6, P7, P8, P9, P10: CONN_2; SIL-2
Q1, Q2, Q3, Q4, Q5, Q6, Q7: FQP7P06; TO220_VERT
R1, R3, R5, R7, R9, R11, R13: 10k; R3
R2, R4, R6, R8, R10, R12, R14: 100; R3
R15, R16, R17, R18, R19, R20, R21: 680; R3
U1: UA7805CKCS; TO220_VERT
U2: TPIC6C595; DIP-16__300

Connections:
+5V: C2.1, C3.1, U1.1, U2.1, U2.7
+12V: C1.1, P1.2, Q1.1, Q2.1, Q3.1, Q4.1, Q5.1, Q6.1, Q7.1, R1.2, R3.2, R5.2, R7.2, R9.2, R11.2, R13.2, U1.2
GND: C1.2, C2.2, C3.2, D1.2, D2.2, D3.2, D4.2, D5.2, D6.2, D7.2, P1.1, P2.1, P3.1, P4.2, P5.2, P6.2, P7.2, P8.2, P9.2, P10.2, U1.3, U2.8, U2.16
unnamed: D1.1, R15.1
unnamed: D2.1, R16.1
unnamed: D3.1, R17.1
unnamed: D4.1, R18.1
unnamed: D5.1, R19.1
unnamed: D6.1, R20.1
unnamed: D7.1, R21.1
unnamed: P2.2, P3.2, U2.10
unnamed: P2.3, P3.3, U2.15
unnamed: P2.4, U2.2
unnamed: P3.4, U2.9
unnamed: P4.1, Q1.3, R15.2
unnamed: P5.1, Q2.3, R16.2
unnamed: P6.1, Q3.3, R17.2
unnamed: P7.1, Q4.3, R18.2
unnamed: P8.1, Q5.3, R19.2
unnamed: P9.1, Q6.3, R20.2
unnamed: P10.1, Q7.3, R21.2
unnamed: Q1.2, R1.1, R2.1
unnamed: Q2.2, R3.1, R4.1
unnamed: Q3.2, R5.1, R6.1
unnamed: Q4.2, R7.1, R8.1
unnamed: Q5.2, R13.1, R14.1
unnamed: Q6.2, R9.1, R10.1
unnamed: Q7.2, R11.1, R12.1
unnamed: R2.2, U2.3
unnamed: R4.2, U2.4
unnamed: R6.2, U2.5
unnamed: R8.2, U2.6
unnamed: R10.2, U2.12
unnamed: R12.2, U2.13
unnamed: R14.2, U2.11
