cillian64/thegrid/firmware/driverfw/board.h

/*
    ChibiOS - Copyright (C) 2006..2016 Giovanni Di Sirio
    Licensed under the Apache License, Version 2.0 (the "License");
    you may not use this file except in compliance with the License.
    You may obtain a copy of the License at
    http://www.apache.org/licenses/LICENSE-2.0
    Unless required by applicable law or agreed to in writing, software
    distributed under the License is distributed on an "AS IS" BASIS,
    WITHOUT WARRANTIES OR CONDITIONS OF ANY KIND, either express or implied.
    See the License for the specific language governing permissions and
    limitations under the License.
*/

/*
    Generated by gen-board.h.py based on driver.yaml
*/

#ifndef _BOARD_H_
#define _BOARD_H_


/*
    Setup for TheGrid Driver PCB r1
*/

/*
    Board identifier
*/
#define BOARD_THEGRIDDRIVER
#define BOARD_NAME                     "TheGrid Driver PCB r1"

/*
    Board oscillators-related settings.
*/
#if !defined(STM32_LSECLK)
#define STM32_LSECLK                   0U
#endif

#if !defined(STM32_HSECLK)
#define STM32_HSECLK                   0U
#endif

#define STM32_LSEDRV (3<<3)
#define STM32_HSEBYPASS

/*
    Board voltages
    Required for performance limits calculation.
*/
#define STM32_VDD                      330U

/*
    MCU type as defined in the ST header.
*/
#define STM32F042x6

/*
    IO pins assignments.
*/

#define GPIOA_PIN0                     0U
#define GPIOA_PIN1                     1U
#define GPIOA_TX                       2U
#define GPIOA_PIN3                     3U
#define GPIOA_PIN4                     4U
#define GPIOA_SCK                      5U
#define GPIOA_NSS                      6U
#define GPIOA_DATA                     7U
#define GPIOA_PIN8                     8U
#define GPIOA_PIN9                     9U
#define GPIOA_PIN10                    10U
#define GPIOA_PIN11                    11U
#define GPIOA_PIN12                    12U
#define GPIOA_SWDIO                    13U
#define GPIOA_SWCLK                    14U
#define GPIOA_PIN15                    15U

#define GPIOB_PIN0                     0U
#define GPIOB_PIN1                     1U
#define GPIOB_PIN2                     2U
#define GPIOB_PIN3                     3U
#define GPIOB_PIN4                     4U
#define GPIOB_PIN5                     5U
#define GPIOB_PIN6                     6U
#define GPIOB_PIN7                     7U
#define GPIOB_PIN8                     8U
#define GPIOB_PIN9                     9U
#define GPIOB_PIN10                    10U
#define GPIOB_PIN11                    11U
#define GPIOB_PIN12                    12U
#define GPIOB_PIN13                    13U
#define GPIOB_PIN14                    14U
#define GPIOB_PIN15                    15U

#define GPIOC_PIN0                     0U
#define GPIOC_PIN1                     1U
#define GPIOC_PIN2                     2U
#define GPIOC_PIN3                     3U
#define GPIOC_PIN4                     4U
#define GPIOC_PIN5                     5U
#define GPIOC_PIN6                     6U
#define GPIOC_PIN7                     7U
#define GPIOC_PIN8                     8U
#define GPIOC_PIN9                     9U
#define GPIOC_PIN10                    10U
#define GPIOC_PIN11                    11U
#define GPIOC_PIN12                    12U
#define GPIOC_PIN13                    13U
#define GPIOC_PIN14                    14U
#define GPIOC_PIN15                    15U

#define GPIOD_PIN0                     0U
#define GPIOD_PIN1                     1U
#define GPIOD_PIN2                     2U
#define GPIOD_PIN3                     3U
#define GPIOD_PIN4                     4U
#define GPIOD_PIN5                     5U
#define GPIOD_PIN6                     6U
#define GPIOD_PIN7                     7U
#define GPIOD_PIN8                     8U
#define GPIOD_PIN9                     9U
#define GPIOD_PIN10                    10U
#define GPIOD_PIN11                    11U
#define GPIOD_PIN12                    12U
#define GPIOD_PIN13                    13U
#define GPIOD_PIN14                    14U
#define GPIOD_PIN15                    15U

#define GPIOF_PIN0                     0U
#define GPIOF_PIN1                     1U
#define GPIOF_PIN2                     2U
#define GPIOF_PIN3                     3U
#define GPIOF_PIN4                     4U
#define GPIOF_PIN5                     5U
#define GPIOF_PIN6                     6U
#define GPIOF_PIN7                     7U
#define GPIOF_PIN8                     8U
#define GPIOF_PIN9                     9U
#define GPIOF_PIN10                    10U
#define GPIOF_PIN11                    11U
#define GPIOF_PIN12                    12U
#define GPIOF_PIN13                    13U
#define GPIOF_PIN14                    14U
#define GPIOF_PIN15                    15U

/*
    IO lines assignments.
*/

#define LINE_DATA                      PAL_LINE(GPIOA, 7U)
#define LINE_NSS                       PAL_LINE(GPIOA, 6U)
#define LINE_SCK                       PAL_LINE(GPIOA, 5U)
#define LINE_SWCLK                     PAL_LINE(GPIOA, 14U)
#define LINE_SWDIO                     PAL_LINE(GPIOA, 13U)
#define LINE_TX                        PAL_LINE(GPIOA, 2U)

/*
    I/O ports initial setup, this configuration is established soon after reset
    in the initialization code.
     Please refer to the STM32 Reference Manual for details.
*/
#define PIN_MODE_INPUT(n)              (0U << ((n) * 2U))
#define PIN_MODE_OUTPUT(n)             (1U << ((n) * 2U))
#define PIN_MODE_ALTERNATE(n)          (2U << ((n) * 2U))
#define PIN_MODE_ANALOG(n)             (3U << ((n) * 2U))
#define PIN_OD_LOW(n)                  (0U << (n))
#define PIN_OD_HIGH(n)                 (1U << (n))
#define PIN_OTYPE_PUSHPULL(n)          (0U << (n))
#define PIN_OTYPE_OPENDRAIN(n)         (1U << (n))
#define PIN_OSPEED_VERYLOW(n)          (0U << ((n) * 2U))
#define PIN_OSPEED_LOW(n)              (1U << ((n) * 2U))
#define PIN_OSPEED_MEDIUM(n)           (2U << ((n) * 2U))
#define PIN_OSPEED_HIGH(n)             (3U << ((n) * 2U))
#define PIN_PUPD_FLOATING(n)           (0U << ((n) * 2U))
#define PIN_PUPD_PULLUP(n)             (1U << ((n) * 2U))
#define PIN_PUPD_PULLDOWN(n)           (2U << ((n) * 2U))
#define PIN_AFIO_AF(n, v)              ((v) << (((n) % 8U) * 4U))

/*
 *  GPIOA setup:
 *
 * PA0  - PIN0                         (unused).
 * PA1  - PIN1                         (unused).
 * PA2  - TX                           (af1).
 * PA3  - PIN3                         (unused).
 * PA4  - PIN4                         (unused).
 * PA5  - SCK                          (af0).
 * PA6  - NSS                          (output).
 * PA7  - DATA                         (af0).
 * PA8  - PIN8                         (unused).
 * PA9  - PIN9                         (unused).
 * PA10 - PIN10                        (unused).
 * PA11 - PIN11                        (unused).
 * PA12 - PIN12                        (unused).
 * PA13 - SWDIO                        (af0).
 * PA14 - SWCLK                        (pulldown, af0).
 * PA15 - PIN15                        (unused).
*/
#define VAL_GPIOA_MODER                (PIN_MODE_INPUT(GPIOA_PIN0) | \
                                        PIN_MODE_INPUT(GPIOA_PIN1) | \
                                        PIN_MODE_ALTERNATE(GPIOA_TX) | \
                                        PIN_MODE_INPUT(GPIOA_PIN3) | \
                                        PIN_MODE_INPUT(GPIOA_PIN4) | \
                                        PIN_MODE_ALTERNATE(GPIOA_SCK) | \
                                        PIN_MODE_OUTPUT(GPIOA_NSS) | \
                                        PIN_MODE_ALTERNATE(GPIOA_DATA) | \
                                        PIN_MODE_INPUT(GPIOA_PIN8) | \
                                        PIN_MODE_INPUT(GPIOA_PIN9) | \
                                        PIN_MODE_INPUT(GPIOA_PIN10) | \
                                        PIN_MODE_INPUT(GPIOA_PIN11) | \
                                        PIN_MODE_INPUT(GPIOA_PIN12) | \
                                        PIN_MODE_ALTERNATE(GPIOA_SWDIO) | \
                                        PIN_MODE_ALTERNATE(GPIOA_SWCLK) | \
                                        PIN_MODE_INPUT(GPIOA_PIN15))
#define VAL_GPIOA_OTYPER               (PIN_OTYPE_PUSHPULL(GPIOA_PIN0) | \
                                        PIN_OTYPE_PUSHPULL(GPIOA_PIN1) | \
                                        PIN_OTYPE_PUSHPULL(GPIOA_TX) | \
                                        PIN_OTYPE_PUSHPULL(GPIOA_PIN3) | \
                                        PIN_OTYPE_PUSHPULL(GPIOA_PIN4) | \
                                        PIN_OTYPE_PUSHPULL(GPIOA_SCK) | \
                                        PIN_OTYPE_PUSHPULL(GPIOA_NSS) | \
                                        PIN_OTYPE_PUSHPULL(GPIOA_DATA) | \
                                        PIN_OTYPE_PUSHPULL(GPIOA_PIN8) | \
                                        PIN_OTYPE_PUSHPULL(GPIOA_PIN9) | \
                                        PIN_OTYPE_PUSHPULL(GPIOA_PIN10) | \
                                        PIN_OTYPE_PUSHPULL(GPIOA_PIN11) | \
                                        PIN_OTYPE_PUSHPULL(GPIOA_PIN12) | \
                                        PIN_OTYPE_PUSHPULL(GPIOA_SWDIO) | \
                                        PIN_OTYPE_PUSHPULL(GPIOA_SWCLK) | \
                                        PIN_OTYPE_PUSHPULL(GPIOA_PIN15))
#define VAL_GPIOA_OSPEEDR              (PIN_OSPEED_HIGH(GPIOA_PIN0) | \
                                        PIN_OSPEED_HIGH(GPIOA_PIN1) | \
                                        PIN_OSPEED_HIGH(GPIOA_TX) | \
                                        PIN_OSPEED_HIGH(GPIOA_PIN3) | \
                                        PIN_OSPEED_HIGH(GPIOA_PIN4) | \
                                        PIN_OSPEED_HIGH(GPIOA_SCK) | \
                                        PIN_OSPEED_HIGH(GPIOA_NSS) | \
                                        PIN_OSPEED_HIGH(GPIOA_DATA) | \
                                        PIN_OSPEED_HIGH(GPIOA_PIN8) | \
                                        PIN_OSPEED_HIGH(GPIOA_PIN9) | \
                                        PIN_OSPEED_HIGH(GPIOA_PIN10) | \
                                        PIN_OSPEED_HIGH(GPIOA_PIN11) | \
                                        PIN_OSPEED_HIGH(GPIOA_PIN12) | \
                                        PIN_OSPEED_HIGH(GPIOA_SWDIO) | \
                                        PIN_OSPEED_HIGH(GPIOA_SWCLK) | \
                                        PIN_OSPEED_HIGH(GPIOA_PIN15))
#define VAL_GPIOA_PUPDR                (PIN_PUPD_PULLUP(GPIOA_PIN0) | \
                                        PIN_PUPD_PULLUP(GPIOA_PIN1) | \
                                        PIN_PUPD_PULLUP(GPIOA_TX) | \
                                        PIN_PUPD_PULLUP(GPIOA_PIN3) | \
                                        PIN_PUPD_PULLUP(GPIOA_PIN4) | \
                                        PIN_PUPD_PULLUP(GPIOA_SCK) | \
                                        PIN_PUPD_PULLUP(GPIOA_NSS) | \
                                        PIN_PUPD_PULLUP(GPIOA_DATA) | \
                                        PIN_PUPD_PULLUP(GPIOA_PIN8) | \
                                        PIN_PUPD_PULLUP(GPIOA_PIN9) | \
                                        PIN_PUPD_PULLUP(GPIOA_PIN10) | \
                                        PIN_PUPD_PULLUP(GPIOA_PIN11) | \
                                        PIN_PUPD_PULLUP(GPIOA_PIN12) | \
                                        PIN_PUPD_PULLUP(GPIOA_SWDIO) | \
                                        PIN_PUPD_PULLDOWN(GPIOA_SWCLK) | \
                                        PIN_PUPD_PULLUP(GPIOA_PIN15))
#define VAL_GPIOA_ODR                  (PIN_OD_HIGH(GPIOA_PIN0) | \
                                        PIN_OD_HIGH(GPIOA_PIN1) | \
                                        PIN_OD_HIGH(GPIOA_TX) | \
                                        PIN_OD_HIGH(GPIOA_PIN3) | \
                                        PIN_OD_HIGH(GPIOA_PIN4) | \
                                        PIN_OD_HIGH(GPIOA_SCK) | \
                                        PIN_OD_HIGH(GPIOA_NSS) | \
                                        PIN_OD_HIGH(GPIOA_DATA) | \
                                        PIN_OD_HIGH(GPIOA_PIN8) | \
                                        PIN_OD_HIGH(GPIOA_PIN9) | \
                                        PIN_OD_HIGH(GPIOA_PIN10) | \
                                        PIN_OD_HIGH(GPIOA_PIN11) | \
                                        PIN_OD_HIGH(GPIOA_PIN12) | \
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
                                        PIN_OD_HIGH(GPIOF_PIN2) | \
                                        PIN_OD_HIGH(GPIOF_PIN3) | \
                                        PIN_OD_HIGH(GPIOF_PIN4) | \
                                        PIN_OD_HIGH(GPIOF_PIN5) | \
                                        PIN_OD_HIGH(GPIOF_PIN6) | \
                                        PIN_OD_HIGH(GPIOF_PIN7) | \
                                        PIN_OD_HIGH(GPIOF_PIN8) | \
                                        PIN_OD_HIGH(GPIOF_PIN9) | \
                                        PIN_OD_HIGH(GPIOF_PIN10) | \
                                        PIN_OD_HIGH(GPIOF_PIN11) | \
                                        PIN_OD_HIGH(GPIOF_PIN12) | \
                                        PIN_OD_HIGH(GPIOF_PIN13) | \
                                        PIN_OD_HIGH(GPIOF_PIN14) | \
                                        PIN_OD_HIGH(GPIOF_PIN15))
#define VAL_GPIOF_AFRL                 (PIN_AFIO_AF(GPIOF_PIN0, 0U) | \
                                        PIN_AFIO_AF(GPIOF_PIN1, 0U) | \
                                        PIN_AFIO_AF(GPIOF_PIN2, 0U) | \
                                        PIN_AFIO_AF(GPIOF_PIN3, 0U) | \
                                        PIN_AFIO_AF(GPIOF_PIN4, 0U) | \
                                        PIN_AFIO_AF(GPIOF_PIN5, 0U) | \
                                        PIN_AFIO_AF(GPIOF_PIN6, 0U) | \
                                        PIN_AFIO_AF(GPIOF_PIN7, 0U))
#define VAL_GPIOF_AFRH                 (PIN_AFIO_AF(GPIOF_PIN8, 0U) | \
                                        PIN_AFIO_AF(GPIOF_PIN9, 0U) | \
                                        PIN_AFIO_AF(GPIOF_PIN10, 0U) | \
                                        PIN_AFIO_AF(GPIOF_PIN11, 0U) | \
                                        PIN_AFIO_AF(GPIOF_PIN12, 0U) | \
                                        PIN_AFIO_AF(GPIOF_PIN13, 0U) | \
                                        PIN_AFIO_AF(GPIOF_PIN14, 0U) | \
                                        PIN_AFIO_AF(GPIOF_PIN15, 0U))

#if !defined(_FROM_ASM_)
#ifdef __cplusplus
extern "C" {
#endif
  void boardInit(void);
#ifdef __cplusplus
}
#endif
#endif /* _FROM_ASM_ */

#endif /* _BOARD_H_ */
