cillian64/thegrid/firmware/polefw/board.h

/*
    ChibiOS - Copyright (C) 2006..2015 Giovanni Di Sirio

    Licensed under the Apache License, Version 2.0 (the "License");
    you may not use this file except in compliance with the License.
    You may obtain a copy of the License at

        http://www.apache.org/licenses/LICENSE-2.0

    Unless required by applicable law or agreed to in writing, software
    distributed under the License is distributed on an "AS IS" BASIS,
    WITHOUT WARRANTIES OR CONDITIONS OF ANY KIND, either express or implied.
    See the License for the specific language governing permissions and
    limitations under the License.
*/

#ifndef _BOARD_H_
#define _BOARD_H_

/*
 * Board identifier.
 */
#define BOARD_ST_STM32F0_DISCOVERY
#define BOARD_NAME                  "TheGrid Pole PCB r1"

/* RGB LED channels */
#define LED_GRN 0
#define LED_RED 1
#define LED_BLU 2

/*
 * Board oscillators-related settings.
 * NOTE: LSE not fitted.
 * NOTE: HSE not fitted.
 */
#if !defined(STM32_LSECLK)
#define STM32_LSECLK                0U
#endif

#define STM32_LSEDRV                (3U << 3U)

#if !defined(STM32_HSECLK)
#define STM32_HSECLK                0U
#endif

#define STM32_HSE_BYPASS

/*
 * MCU type as defined in the ST header.
 */
#define STM32F051x8

/*
 * IO pins assignments.
 */
#define GPIOA_PIN0                  0U
#define GPIOA_PIN1                  1U
#define GPIOA_PIN2                  2U
#define GPIOA_BUS                   3U
#define GPIOA_PIEZO                 4U
#define GPIOA_PIN5                  5U
#define GPIOA_PIN6                  6U
#define GPIOA_PIN7                  7U
#define GPIOA_LED_R                 8U
#define GPIOA_LED_G                 9U
#define GPIOA_LED_B                 10U
#define GPIOA_PIN11                 11U
#define GPIOA_PIN12                 12U
#define GPIOA_SWDAT                 13U
#define GPIOA_SWCLK                 14U
#define GPIOA_PIN15                 15U

#define GPIOB_PIN0                  0U
#define GPIOB_PIN1                  1U
#define GPIOB_PIN2                  2U
#define GPIOB_PIN3                  3U
#define GPIOB_PIN4                  4U
#define GPIOB_PIN5                  5U
#define GPIOB_PIN6                  6U
#define GPIOB_PIN7                  7U
#define GPIOB_PIN8                  8U
#define GPIOB_PIN9                  9U
#define GPIOB_PIN10                 10U
#define GPIOB_PIN11                 11U
#define GPIOB_PIN12                 12U
#define GPIOB_PIN13                 13U
#define GPIOB_PIN14                 14U
#define GPIOB_PIN15                 15U

#define GPIOC_PIN0                  0U
#define GPIOC_PIN1                  1U
#define GPIOC_PIN2                  2U
#define GPIOC_PIN3                  3U
#define GPIOC_PIN4                  4U
#define GPIOC_PIN5                  5U
#define GPIOC_PIN6                  6U
#define GPIOC_PIN7                  7U
#define GPIOC_PIN8                  8U
#define GPIOC_PIN9                  9U
#define GPIOC_PIN10                 10U
#define GPIOC_PIN11                 11U
#define GPIOC_PIN12                 12U
#define GPIOC_PIN13                 13U
#define GPIOC_OSC32_IN              14U
#define GPIOC_OSC32_OUT             15U

#define GPIOD_PIN0                  0U
#define GPIOD_PIN1                  1U
#define GPIOD_PIN2                  2U
#define GPIOD_PIN3                  3U
#define GPIOD_PIN4                  4U
#define GPIOD_PIN5                  5U
#define GPIOD_PIN6                  6U
#define GPIOD_PIN7                  7U
#define GPIOD_PIN8                  8U
#define GPIOD_PIN9                  9U
#define GPIOD_PIN10                 10U
#define GPIOD_PIN11                 11U
#define GPIOD_PIN12                 12U
#define GPIOD_PIN13                 13U
#define GPIOD_PIN14                 14U
#define GPIOD_PIN15                 15U

#define GPIOF_OSC_IN                0U
#define GPIOF_OSC_OUT               1U
#define GPIOF_PIN2                  2U
#define GPIOF_PIN3                  3U
#define GPIOF_PIN4                  4U
#define GPIOF_PIN5                  5U
#define GPIOF_PIN6                  6U
#define GPIOF_PIN7                  7U
#define GPIOF_PIN8                  8U
#define GPIOF_PIN9                  9U
#define GPIOF_PIN10                 10U
#define GPIOF_PIN11                 11U
#define GPIOF_PIN12                 12U
#define GPIOF_PIN13                 13U
#define GPIOF_PIN14                 14U
#define GPIOF_PIN15                 15U

/*
 * IO lines assignments.
 */
#define LINE_BUS                    PAL_LINE(GPIOA, 3U)
#define LINE_PIEZO                  PAL_LINE(GPIOA, 4U)
#define LINE_LED_R                  PAL_LINE(GPIOA, 8U)
#define LINE_LED_G                  PAL_LINE(GPIOA, 9U)
#define LINE_LED_B                  PAL_LINE(GPIOA, 10U)
#define LINE_SWDAT                  PAL_LINE(GPIOA, 13U)
#define LINE_SWCLK                  PAL_LINE(GPIOA, 14U)


#define LINE_OSC32_IN               PAL_LINE(GPIOC, 14U)
#define LINE_OSC32_OUT              PAL_LINE(GPIOC, 15U)


#define LINE_OSC_IN                 PAL_LINE(GPIOF, 0U)
#define LINE_OSC_OUT                PAL_LINE(GPIOF, 1U)

/*
 * I/O ports initial setup, this configuration is established soon after reset
 * in the initialization code.
 * Please refer to the STM32 Reference Manual for details.
 */
#define PIN_MODE_INPUT(n)           (0U << ((n) * 2U))
#define PIN_MODE_OUTPUT(n)          (1U << ((n) * 2U))
#define PIN_MODE_ALTERNATE(n)       (2U << ((n) * 2U))
#define PIN_MODE_ANALOG(n)          (3U << ((n) * 2U))
#define PIN_ODR_LOW(n)              (0U << (n))
#define PIN_ODR_HIGH(n)             (1U << (n))
#define PIN_OTYPE_PUSHPULL(n)       (0U << (n))
#define PIN_OTYPE_OPENDRAIN(n)      (1U << (n))
#define PIN_OSPEED_VERYLOW(n)       (0U << ((n) * 2U))
#define PIN_OSPEED_LOW(n)           (1U << ((n) * 2U))
#define PIN_OSPEED_MEDIUM(n)        (2U << ((n) * 2U))
#define PIN_OSPEED_HIGH(n)          (3U << ((n) * 2U))
#define PIN_PUPDR_FLOATING(n)       (0U << ((n) * 2U))
#define PIN_PUPDR_PULLUP(n)         (1U << ((n) * 2U))
#define PIN_PUPDR_PULLDOWN(n)       (2U << ((n) * 2U))
#define PIN_AFIO_AF(n, v)           ((v) << (((n) % 8U) * 4U))

#define VAL_GPIOA_MODER             (PIN_MODE_INPUT(GPIOA_PIN0)   |           \
                                     PIN_MODE_INPUT(GPIOA_PIN1)   |           \
                                     PIN_MODE_INPUT(GPIOA_PIN2)   |           \
                                     PIN_MODE_ALTERNATE(GPIOA_BUS)|           \
                                     PIN_MODE_ANALOG(GPIOA_PIEZO) |           \
                                     PIN_MODE_INPUT(GPIOA_PIN5)   |           \
                                     PIN_MODE_INPUT(GPIOA_PIN6)   |           \
                                     PIN_MODE_INPUT(GPIOA_PIN7)   |           \
                                     PIN_MODE_ALTERNATE(GPIOA_LED_R) |        \
                                     PIN_MODE_ALTERNATE(GPIOA_LED_G) |        \
                                     PIN_MODE_ALTERNATE(GPIOA_LED_B) |        \
                                     PIN_MODE_INPUT(GPIOA_PIN11)  |           \
                                     PIN_MODE_INPUT(GPIOA_PIN12)  |           \
                                     PIN_MODE_ALTERNATE(GPIOA_SWDAT) |        \
                                     PIN_MODE_ALTERNATE(GPIOA_SWCLK) |        \
                                     PIN_MODE_INPUT(GPIOA_PIN15))
#define VAL_GPIOA_OTYPER            (PIN_OTYPE_PUSHPULL(GPIOA_PIN0) |     \
                                     PIN_OTYPE_PUSHPULL(GPIOA_PIN1) |       \
                                     PIN_OTYPE_PUSHPULL(GPIOA_PIN2) |       \
                                     PIN_OTYPE_PUSHPULL(GPIOA_BUS) |       \
                                     PIN_OTYPE_PUSHPULL(GPIOA_PIEZO) |       \
                                     PIN_OTYPE_PUSHPULL(GPIOA_PIN5) |       \
                                     PIN_OTYPE_PUSHPULL(GPIOA_PIN6) |       \
                                     PIN_OTYPE_PUSHPULL(GPIOA_PIN7) |       \
                                     PIN_OTYPE_PUSHPULL(GPIOA_LED_R) |       \
                                     PIN_OTYPE_PUSHPULL(GPIOA_LED_G) |       \
                                     PIN_OTYPE_PUSHPULL(GPIOA_LED_B) |      \
                                     PIN_OTYPE_PUSHPULL(GPIOA_PIN11) |      \
                                     PIN_OTYPE_PUSHPULL(GPIOA_PIN12) |      \
                                     PIN_OTYPE_PUSHPULL(GPIOA_SWDAT) |      \
                                     PIN_OTYPE_PUSHPULL(GPIOA_SWCLK) |      \
                                     PIN_OTYPE_PUSHPULL(GPIOA_PIN15))
#define VAL_GPIOA_OSPEEDR           (PIN_OSPEED_VERYLOW(GPIOA_PIN0) |     \
                                     PIN_OSPEED_VERYLOW(GPIOA_PIN1) |       \
                                     PIN_OSPEED_VERYLOW(GPIOA_PIN2) |       \
                                     PIN_OSPEED_VERYLOW(GPIOA_BUS) |       \
                                     PIN_OSPEED_HIGH(GPIOA_PIEZO) |       \
                                     PIN_OSPEED_VERYLOW(GPIOA_PIN5) |       \
                                     PIN_OSPEED_VERYLOW(GPIOA_PIN6) |       \
                                     PIN_OSPEED_VERYLOW(GPIOA_PIN7) |       \
                                     PIN_OSPEED_HIGH(GPIOA_LED_R) |       \
                                     PIN_OSPEED_HIGH(GPIOA_LED_G) |       \
                                     PIN_OSPEED_HIGH(GPIOA_LED_B) |      \
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
                                     PIN_ODR_HIGH(GPIOB_PIN9) |             \
                                     PIN_ODR_HIGH(GPIOB_PIN10) |            \
                                     PIN_ODR_HIGH(GPIOB_PIN11) |            \
                                     PIN_ODR_HIGH(GPIOB_PIN12) |            \
                                     PIN_ODR_HIGH(GPIOB_PIN13) |            \
                                     PIN_ODR_HIGH(GPIOB_PIN14) |            \
                                     PIN_ODR_HIGH(GPIOB_PIN15))
#define VAL_GPIOB_AFRL              (PIN_AFIO_AF(GPIOB_PIN0, 0) |           \
                                     PIN_AFIO_AF(GPIOB_PIN1, 0) |           \
                                     PIN_AFIO_AF(GPIOB_PIN2, 0) |           \
                                     PIN_AFIO_AF(GPIOB_PIN3, 0) |           \
                                     PIN_AFIO_AF(GPIOB_PIN4, 0) |           \
                                     PIN_AFIO_AF(GPIOB_PIN5, 0) |           \
                                     PIN_AFIO_AF(GPIOB_PIN6, 0) |           \
                                     PIN_AFIO_AF(GPIOB_PIN7, 0))
#define VAL_GPIOB_AFRH              (PIN_AFIO_AF(GPIOB_PIN8, 0) |           \
                                     PIN_AFIO_AF(GPIOB_PIN9, 0) |           \
                                     PIN_AFIO_AF(GPIOB_PIN10, 0) |          \
                                     PIN_AFIO_AF(GPIOB_PIN11, 0) |          \
                                     PIN_AFIO_AF(GPIOB_PIN12, 0) |          \
                                     PIN_AFIO_AF(GPIOB_PIN13, 0) |          \
                                     PIN_AFIO_AF(GPIOB_PIN14, 0) |          \
                                     PIN_AFIO_AF(GPIOB_PIN15, 0))

#define VAL_GPIOC_MODER             (PIN_MODE_INPUT(GPIOC_PIN0) |           \
                                     PIN_MODE_INPUT(GPIOC_PIN1) |           \
                                     PIN_MODE_INPUT(GPIOC_PIN2) |           \
                                     PIN_MODE_INPUT(GPIOC_PIN3) |           \
                                     PIN_MODE_INPUT(GPIOC_PIN4) |           \
                                     PIN_MODE_INPUT(GPIOC_PIN5) |           \
                                     PIN_MODE_INPUT(GPIOC_PIN6) |           \
                                     PIN_MODE_INPUT(GPIOC_PIN7) |           \
                                     PIN_MODE_INPUT(GPIOC_PIN8) |          \
                                     PIN_MODE_INPUT(GPIOC_PIN9) |          \
                                     PIN_MODE_INPUT(GPIOC_PIN10) |          \
                                     PIN_MODE_INPUT(GPIOC_PIN11) |          \
                                     PIN_MODE_INPUT(GPIOC_PIN12) |          \
                                     PIN_MODE_INPUT(GPIOC_PIN13) |          \
                                     PIN_MODE_INPUT(GPIOC_OSC32_IN) |       \
                                     PIN_MODE_INPUT(GPIOC_OSC32_OUT))
#define VAL_GPIOC_OTYPER            (PIN_OTYPE_PUSHPULL(GPIOC_PIN0) |       \
                                     PIN_OTYPE_PUSHPULL(GPIOC_PIN1) |       \
                                     PIN_OTYPE_PUSHPULL(GPIOC_PIN2) |       \
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
                                     PIN_ODR_HIGH(GPIOC_PIN9) |              \
                                     PIN_ODR_HIGH(GPIOC_PIN10) |            \
                                     PIN_ODR_HIGH(GPIOC_PIN11) |            \
                                     PIN_ODR_HIGH(GPIOC_PIN12) |            \
                                     PIN_ODR_HIGH(GPIOC_PIN13) |            \
                                     PIN_ODR_HIGH(GPIOC_OSC32_IN) |         \
                                     PIN_ODR_HIGH(GPIOC_OSC32_OUT))
#define VAL_GPIOC_AFRL              (PIN_AFIO_AF(GPIOC_PIN0, 0) |           \
                                     PIN_AFIO_AF(GPIOC_PIN1, 0) |           \
                                     PIN_AFIO_AF(GPIOC_PIN2, 0) |           \
                                     PIN_AFIO_AF(GPIOC_PIN3, 0) |           \
                                     PIN_AFIO_AF(GPIOC_PIN4, 0) |           \
                                     PIN_AFIO_AF(GPIOC_PIN5, 0) |           \
                                     PIN_AFIO_AF(GPIOC_PIN6, 0) |           \
                                     PIN_AFIO_AF(GPIOC_PIN7, 0))
#define VAL_GPIOC_AFRH              (PIN_AFIO_AF(GPIOC_PIN8, 0) |           \
                                     PIN_AFIO_AF(GPIOC_PIN9, 0) |           \
                                     PIN_AFIO_AF(GPIOC_PIN10, 0) |          \
                                     PIN_AFIO_AF(GPIOC_PIN11, 0) |          \
                                     PIN_AFIO_AF(GPIOC_PIN12, 0) |          \
                                     PIN_AFIO_AF(GPIOC_PIN13, 0) |          \
                                     PIN_AFIO_AF(GPIOC_OSC32_IN, 0) |       \
                                     PIN_AFIO_AF(GPIOC_OSC32_OUT, 0))

/*
 * GPIOD setup:
 *
 * PD0  - PIN0                      (input pullup).
 * PD1  - PIN1                      (input pullup).
 * PD2  - PIN2                      (input pullup).
 * PD3  - PIN3                      (input pullup).
 * PD4  - PIN4                      (input pullup).
 * PD5  - PIN5                      (input pullup).
 * PD6  - PIN6                      (input pullup).
 * PD7  - PIN7                      (input pullup).
 * PD8  - PIN8                      (input pullup).
 * PD9  - PIN9                      (input pullup).
 * PD10 - PIN10                     (input pullup).
 * PD11 - PIN11                     (input pullup).
 * PD12 - PIN12                     (input pullup).
 * PD13 - PIN13                     (input pullup).
 * PD14 - PIN14                     (input pullup).
 * PD15 - PIN15                     (input pullup).
 */
#define VAL_GPIOD_MODER             (PIN_MODE_INPUT(GPIOD_PIN0) |           \
                                     PIN_MODE_INPUT(GPIOD_PIN1) |           \
                                     PIN_MODE_INPUT(GPIOD_PIN2) |           \
                                     PIN_MODE_INPUT(GPIOD_PIN3) |           \
                                     PIN_MODE_INPUT(GPIOD_PIN4) |           \
                                     PIN_MODE_INPUT(GPIOD_PIN5) |           \
                                     PIN_MODE_INPUT(GPIOD_PIN6) |           \
                                     PIN_MODE_INPUT(GPIOD_PIN7) |           \
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
                                     PIN_AFIO_AF(GPIOD_PIN13, 0) |          \
                                     PIN_AFIO_AF(GPIOD_PIN14, 0) |          \
                                     PIN_AFIO_AF(GPIOD_PIN15, 0))

/*
 * GPIOF setup:
 *
 * PF0  - OSC_IN                    (input floating).
 * PF1  - OSC_OUT                   (input floating).
 * PF2  - PIN2                      (input pullup).
 * PF3  - PIN3                      (input pullup).
 * PF4  - PIN4                      (input pullup).
 * PF5  - PIN5                      (input pullup).
 * PF6  - PIN6                      (input pullup).
 * PF7  - PIN7                      (input pullup).
 * PF8  - PIN8                      (input pullup).
 * PF9  - PIN9                      (input pullup).
 * PF10 - PIN10                     (input pullup).
 * PF11 - PIN11                     (input pullup).
 * PF12 - PIN12                     (input pullup).
 * PF13 - PIN13                     (input pullup).
 * PF14 - PIN14                     (input pullup).
 * PF15 - PIN15                     (input pullup).
 */
#define VAL_GPIOF_MODER             (PIN_MODE_INPUT(GPIOF_OSC_IN) |         \
                                     PIN_MODE_INPUT(GPIOF_OSC_OUT) |        \
                                     PIN_MODE_INPUT(GPIOF_PIN2) |           \
                                     PIN_MODE_INPUT(GPIOF_PIN3) |           \
                                     PIN_MODE_INPUT(GPIOF_PIN4) |           \
                                     PIN_MODE_INPUT(GPIOF_PIN5) |           \
                                     PIN_MODE_INPUT(GPIOF_PIN6) |           \
                                     PIN_MODE_INPUT(GPIOF_PIN7) |           \
                                     PIN_MODE_INPUT(GPIOF_PIN8) |           \
                                     PIN_MODE_INPUT(GPIOF_PIN9) |           \
                                     PIN_MODE_INPUT(GPIOF_PIN10) |          \
                                     PIN_MODE_INPUT(GPIOF_PIN11) |          \
                                     PIN_MODE_INPUT(GPIOF_PIN12) |          \
                                     PIN_MODE_INPUT(GPIOF_PIN13) |          \
                                     PIN_MODE_INPUT(GPIOF_PIN14) |          \
                                     PIN_MODE_INPUT(GPIOF_PIN15))
#define VAL_GPIOF_OTYPER            (PIN_OTYPE_PUSHPULL(GPIOF_OSC_IN) |     \
                                     PIN_OTYPE_PUSHPULL(GPIOF_OSC_OUT) |    \
                                     PIN_OTYPE_PUSHPULL(GPIOF_PIN2) |       \
                                     PIN_OTYPE_PUSHPULL(GPIOF_PIN3) |       \
                                     PIN_OTYPE_PUSHPULL(GPIOF_PIN4) |       \
                                     PIN_OTYPE_PUSHPULL(GPIOF_PIN5) |       \
                                     PIN_OTYPE_PUSHPULL(GPIOF_PIN6) |       \
                                     PIN_OTYPE_PUSHPULL(GPIOF_PIN7) |       \
                                     PIN_OTYPE_PUSHPULL(GPIOF_PIN8) |       \
                                     PIN_OTYPE_PUSHPULL(GPIOF_PIN9) |       \
                                     PIN_OTYPE_PUSHPULL(GPIOF_PIN10) |      \
                                     PIN_OTYPE_PUSHPULL(GPIOF_PIN11) |      \
                                     PIN_OTYPE_PUSHPULL(GPIOF_PIN12) |      \
                                     PIN_OTYPE_PUSHPULL(GPIOF_PIN13) |      \
                                     PIN_OTYPE_PUSHPULL(GPIOF_PIN14) |      \
                                     PIN_OTYPE_PUSHPULL(GPIOF_PIN15))
#define VAL_GPIOF_OSPEEDR           (PIN_OSPEED_VERYLOW(GPIOF_OSC_IN) |     \
                                     PIN_OSPEED_VERYLOW(GPIOF_OSC_OUT) |    \
                                     PIN_OSPEED_VERYLOW(GPIOF_PIN2) |       \
                                     PIN_OSPEED_VERYLOW(GPIOF_PIN3) |       \
                                     PIN_OSPEED_VERYLOW(GPIOF_PIN4) |       \
                                     PIN_OSPEED_VERYLOW(GPIOF_PIN5) |       \
                                     PIN_OSPEED_VERYLOW(GPIOF_PIN6) |       \
                                     PIN_OSPEED_VERYLOW(GPIOF_PIN7) |       \
                                     PIN_OSPEED_VERYLOW(GPIOF_PIN8) |       \
                                     PIN_OSPEED_VERYLOW(GPIOF_PIN9) |       \
                                     PIN_OSPEED_VERYLOW(GPIOF_PIN10) |      \
                                     PIN_OSPEED_VERYLOW(GPIOF_PIN11) |      \
                                     PIN_OSPEED_VERYLOW(GPIOF_PIN12) |      \
                                     PIN_OSPEED_VERYLOW(GPIOF_PIN13) |      \
                                     PIN_OSPEED_VERYLOW(GPIOF_PIN14) |      \
                                     PIN_OSPEED_VERYLOW(GPIOF_PIN15))
#define VAL_GPIOF_PUPDR             (PIN_PUPDR_FLOATING(GPIOF_OSC_IN) |     \
                                     PIN_PUPDR_FLOATING(GPIOF_OSC_OUT) |    \
                                     PIN_PUPDR_PULLUP(GPIOF_PIN2) |         \
                                     PIN_PUPDR_PULLUP(GPIOF_PIN3) |         \
                                     PIN_PUPDR_PULLUP(GPIOF_PIN4) |         \
                                     PIN_PUPDR_PULLUP(GPIOF_PIN5) |         \
                                     PIN_PUPDR_PULLUP(GPIOF_PIN6) |         \
                                     PIN_PUPDR_PULLUP(GPIOF_PIN7) |         \
                                     PIN_PUPDR_PULLUP(GPIOF_PIN8) |         \
                                     PIN_PUPDR_PULLUP(GPIOF_PIN9) |         \
                                     PIN_PUPDR_PULLUP(GPIOF_PIN10) |        \
                                     PIN_PUPDR_PULLUP(GPIOF_PIN11) |        \
                                     PIN_PUPDR_PULLUP(GPIOF_PIN12) |        \
                                     PIN_PUPDR_PULLUP(GPIOF_PIN13) |        \
                                     PIN_PUPDR_PULLUP(GPIOF_PIN14) |        \
                                     PIN_PUPDR_PULLUP(GPIOF_PIN15))
#define VAL_GPIOF_ODR               (PIN_ODR_HIGH(GPIOF_OSC_IN) |           \
                                     PIN_ODR_HIGH(GPIOF_OSC_OUT) |          \
                                     PIN_ODR_HIGH(GPIOF_PIN2) |             \
                                     PIN_ODR_HIGH(GPIOF_PIN3) |             \
                                     PIN_ODR_HIGH(GPIOF_PIN4) |             \
                                     PIN_ODR_HIGH(GPIOF_PIN5) |             \
                                     PIN_ODR_HIGH(GPIOF_PIN6) |             \
                                     PIN_ODR_HIGH(GPIOF_PIN7) |             \
                                     PIN_ODR_HIGH(GPIOF_PIN8) |             \
                                     PIN_ODR_HIGH(GPIOF_PIN9) |             \
                                     PIN_ODR_HIGH(GPIOF_PIN10) |            \
                                     PIN_ODR_HIGH(GPIOF_PIN11) |            \
                                     PIN_ODR_HIGH(GPIOF_PIN12) |            \
                                     PIN_ODR_HIGH(GPIOF_PIN13) |            \
                                     PIN_ODR_HIGH(GPIOF_PIN14) |            \
                                     PIN_ODR_HIGH(GPIOF_PIN15))
#define VAL_GPIOF_AFRL              (PIN_AFIO_AF(GPIOF_OSC_IN, 0) |         \
                                     PIN_AFIO_AF(GPIOF_OSC_OUT, 0) |        \
                                     PIN_AFIO_AF(GPIOF_PIN2, 0) |           \
                                     PIN_AFIO_AF(GPIOF_PIN3, 0) |           \
                                     PIN_AFIO_AF(GPIOF_PIN4, 0) |           \
                                     PIN_AFIO_AF(GPIOF_PIN5, 0) |           \
                                     PIN_AFIO_AF(GPIOF_PIN6, 0) |           \
                                     PIN_AFIO_AF(GPIOF_PIN7, 0))
#define VAL_GPIOF_AFRH              (PIN_AFIO_AF(GPIOF_PIN8, 0) |           \
                                     PIN_AFIO_AF(GPIOF_PIN9, 0) |           \
                                     PIN_AFIO_AF(GPIOF_PIN10, 0) |          \
                                     PIN_AFIO_AF(GPIOF_PIN11, 0) |          \
                                     PIN_AFIO_AF(GPIOF_PIN12, 0) |          \
                                     PIN_AFIO_AF(GPIOF_PIN13, 0) |          \
                                     PIN_AFIO_AF(GPIOF_PIN14, 0) |          \
                                     PIN_AFIO_AF(GPIOF_PIN15, 0))

#if !defined(_FROM_ASM_)
#ifdef __cplusplus
extern "C" {
#endif
  void boardInit(void);
#ifdef __cplusplus
}
#endif
#endif /* _FROM_ASM_ */

#endif /* _BOARD_H_ */
