cillian64/thegrid/firmware/driverfw/bus.c

#include "ch.h"
#include "hal.h"
#include "bus.h"
#include "frame.h"

extern binary_semaphore_t frame_thread_sem;
static volatile unsigned int framebuf_ctr = 0;

static const UARTConfig uart_cfg = {
    .txend1_cb = NULL,
    .txend2_cb = NULL,
    .rxend_cb  = NULL,
    .rxchar_cb = NULL,
    .rxerr_cb  = NULL,
    .speed     = 1000000,
    .cr1       = 0,
    .cr2       = USART_CR2_TXINV,
    .cr3       = 0,
};

void bus_init() {
    uartStart(&UARTD2, &uart_cfg);
}

void bus_tx() {
    size_t n = sizeof(Frame);
    uartSendTimeout(&UARTD2, &n, &framebuf.raw, TIME_INFINITE);
}
