cillian64/thegrid/software/thegrid/serial.py

import asyncio
import struct
import serial_asyncio

transport = None


def checksum(data):
    crc = 0xFFFF
    for b in data:
        crc ^= b << 8
        for _ in range(8):
            if crc & 0x8000:
                crc = (crc << 1) ^ 0x1021
            else:
                crc <<= 1
            crc &= 0xFFFF
    return struct.pack("H", crc)


def frame_from_array(poles):
    sync = b"\xFF\xFF\xFF\xFF\xFF\xFF"
    packets = b""
    for row in poles:
        for pole in row:
            packet = struct.pack("6B", *pole[[3, 4, 5, 0, 1, 2]].flat)
            packets += packet + checksum(packet)
    return sync + packets


@asyncio.coroutine
def open(port):
    global transport
    loop = asyncio.get_event_loop()
    reader = asyncio.StreamReader()
    proto = asyncio.StreamReaderProtocol(reader)
    transport, _ = yield from serial_asyncio.create_serial_connection(
        loop, lambda: proto, url=port, baudrate=115200)
    return transport


def write(poles):
    if transport is not None:
        frame = frame_from_array(poles)
        transport.write(frame)

def write_raw(b):
    if transport is not None:
        transport.write(b)
