cillian64/thegrid/(commit log)

2014-06-07 Checkin models and beam calcs script
    [haarp.skp]
2014-06-07 Remade model files using sketchup 2013
    Because 2013 runs happily under wine, and 2014 doesn't.
    [haarp.skp]
2014-06-07 Added initial pole drawing
    [haarp.skp, pole.skp]
2014-06-08 LED weight and 40mph wind
2014-06-11 Added frame counter
2014-06-11 add plan schematic to proposal
2014-06-11 fix length arrows on plan schematic
2014-06-11 add wiring diagram oh god
2014-06-11 horiz cantilever and buckling
2014-06-12 add euler buckling diagram
2014-06-13 update prototype section
2014-07-05 Corrected LED cost in budget
2014-07-05 Initial Gantt chart
    [timing.ods]
2014-07-05 Front loaded gantt chart some more
    [timing.ods]
2014-07-05 Made gantt chart look prettier
    [timing.ods]
2014-07-05 Flight case to parts list and gitignore
    gitignore for openoffice lock file
2014-07-05 Disable `more' button if not summarised
    also increase summary length to 300 *words*
2014-07-06 Added drivers to parts list
2014-07-06 Drivers in parts list
2014-07-07 Web post and farnell cable in parts list
2014-07-10 Updated timing
    [timing.ods]
2014-07-11 Schematic and POC PCB
    [thegrid.kicad_pcb, thegrid.sch]
2014-07-11 10cm x 5cm spacey PCB layout
    [thegrid.kicad_pcb]
2014-07-11 All SMD parts to PTH
    [thegrid.kicad_pcb]
2014-07-11 Added PCB to gantt chart
    [timing.ods]
2014-07-11 Changed TO220 to hs again and moved resistors
    [thegrid.kicad_pcb]
2014-07-11 Blogpost: rework and a PCB
2014-07-12 Schematic touchups and PCB footprint layout
    [thegrid.kicad_pcb, thegrid.sch]
2014-07-12 implement frame timing
2014-07-13 multiple sinks, catch sink and pattern errors
    [control.py]
2014-07-13 use some errors instead of warnings
    [control.py]
2014-07-13 propower minipower led strip connectors
    [thegrid.kicad_pcb]
2014-07-13 Provisionally finished routing
    [thegrid.kicad_pcb]
2014-07-14 Made edges of board fit in 100mm x 50mm
    [thegrid.kicad_pcb]
2014-07-14 Bumped up clearances
    [thegrid.kicad_pcb]
2014-07-14 Bumped via size
    [thegrid.kicad_pcb]
2014-07-14 Bumped thermal clearance spokes
    [thegrid.kicad_pcb]
2014-07-14 Moved silk off vias
    Because Dirty apparently don't tent vias, and probably not ones this chunky!
    [thegrid.kicad_pcb]
2014-07-14 Updated gerbils
    [thegrid.kicad_pcb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]
2014-07-14 Updated gantt chart, ahead of schedule :D
    [farnell_parts.ods, timing.ods]
2014-07-16 LEDs arrived blog post
2014-07-16 yellow pcbs blagpost
2014-07-25 add photos of pcbs
2014-07-25 pcbs blagpost
2014-07-31 Updated BOM
    [farnell_parts.ods]
2014-08-02 cosmetic changes to schematic
    [thegrid.sch]
2014-08-02 specced capacitors
2014-08-03 specced wire-board connector
2014-08-04 blog post on wire and flight case delivery
2014-08-09 track, maintain, save and restore frame data
2014-08-09 add a and d hotkeys for add/delete frame
2014-08-09 remove old prototype code
2014-08-09 fix crash if you go to next frame with no frames
2014-08-09 Change pins to match new connector/ribbon
2014-08-09 Added on.py test pattern and sample (for off)
2014-08-09 add script to work out cable lengths
2014-08-09 update script to bin cables into reels
2014-08-15 First rough sketch of the.grid box
    [all.dxf]
2014-08-15 Camera mast guying rings
    [guying_rings_stacked.dxf]
2014-08-16 Updated gantt chart
    [timing.ods]
2014-08-16 Updated cable length cut list
2014-08-16 cable length script improvements
2014-08-18 Redoing top lasercut properly, nearly done
    [all.dxf]
2014-08-18 Finished top
    [all.dxf]
2014-08-18 Added PSUs, enlarged wiring slots
    [all.dxf]
2014-08-18 Added screwslots
    [all.dxf]
2014-08-19 psu bonus mounting holes
    [all.dxf]
2014-08-19 Relocated PSUs slightly
    [all.dxf]
2014-08-22 updated timing, as usual
    [timing.ods]
2014-08-22 laser cut signs
    [both_signs_text_flattified.dxf, noarduino.dxf]
2014-08-26 additional signs
    [element14.dxf, url.dxf]
2016-03-23 Sketch pole node schematic
    [pole.kicad_pcb, pole.sch]
2016-03-25 Added edge-mount (gross) minipow connector fp
2016-03-25 Removed resistors, added piezo
    [pole.sch]
2016-03-25 Added piezo fp
    [pole.sch]
2016-03-26 VREG footprint
    [pole.sch]
2016-03-27 Chose NMOS, added fp etc
    [pole.sch]
2016-03-27 VREG capacitor values
    [pole.sch]
2016-03-27 Initial layout of f030
    [pole.kicad_pcb, pole.sch]
2016-03-27 Use STM32F051, changed FPs to agg-kicad
    [pole.kicad_pcb, pole.sch]
2016-03-27 Finished pin assignments, first layout
    [pole.kicad_pcb, pole.sch]
2016-03-27 First proof of concept route, with gerbers
    [pole-B.Cu.gbl, pole-B.Mask.gbs, pole-B.SilkS.gbo, pole-F.Cu.gtl, pole-F.Mask.gts, pole-F.Paste.gtp, pole-F.SilkS.gto, pole.drl]
2016-03-27 Added board-outline
    [pole.kicad_pcb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]
2016-03-27 Added shield schematic
    [shield.kicad_pcb, shield.sch]
2016-03-27 Added comparator receiver hysteresis
    [pole-B.Cu.gbl, pole-B.Mask.gbs, pole-B.SilkS.gbo, pole-Edge.Cuts.gm1, pole-F.Cu.gtl, pole-F.Mask.gts, pole-F.Paste.gtp, pole-F.SilkS.gto]
2016-03-27 Added SHIFT connections, sated ERC
    [shield.sch]
2016-03-28 Proof of concept route of shield
    [shield-B.Cu.gbl, shield-B.Mask.gbs, shield-B.SilkS.gbo, shield-Edge.Cuts.gm1, shield-F.Cu.gtl, shield-F.Mask.gts, shield-F.Paste.gtp, shield-F.SilkS.gto]
2016-03-28 Cleared up routing, added+stitched top gnd plane
    [shield.kicad_pcb]
2016-03-28 Moved JST-PAs inward, silk
    [shield-B.Cu.gbl, shield-B.Mask.gbs, shield-B.SilkS.gbo, shield-Edge.Cuts.gm1, shield-F.Cu.gtl, shield-F.Mask.gts, shield-F.Paste.gtp, shield-F.SilkS.gto]
2016-03-28 Shrunk shield board outline to fit 5x5
    [shield-B.Cu.gbl, shield-B.Mask.gbs, shield-B.SilkS.gbo, shield-Edge.Cuts.gm1, shield-F.Cu.gtl, shield-F.Mask.gts, shield-F.Paste.gtp, shield-F.SilkS.gto]
2016-03-28 re-layout and reroute of pole pcb
    [pole.kicad_pcb]
2016-03-28 Added pole silk
    [pole-B.Cu.gbl, pole-B.Mask.gbs, pole-B.SilkS.gbo, pole-Edge.Cuts.gm1, pole-F.Cu.gtl, pole-F.Mask.gts, pole-F.Paste.gtp, pole-F.SilkS.gto]
2016-03-28 Added panellised pole pcb
    [pole_panellised-B.Cu.gbl, pole_panellised-B.Mask.gbs, pole_panellised-B.SilkS.gbo, pole_panellised-Edge.Cuts.gm1, pole_panellised-F.Cu.gtl, pole_panellised-F.Mask.gts, pole_panellised-F.Paste.gtp, pole_panellised-F.SilkS.gto]
2016-03-28 Changed vias from 0.6/0.4 to 0.6/0.3
    [pole.kicad_pcb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]
2016-03-28 Removed erroneous edge cut
    [pole_panellised-B.Cu.gbl, pole_panellised-B.Mask.gbs, pole_panellised-B.SilkS.gbo, pole_panellised-Edge.Cuts.gm1, pole_panellised-F.Cu.gtl, pole_panellised-F.Mask.gts, pole_panellised-F.Paste.gtp, pole_panellised-F.SilkS.gto]
2016-03-29 set mask clearance to 0 and regen gerbers
    [shield-B.Cu.gbl, shield-B.Mask.gbs, shield-B.SilkS.gbo, shield-Edge.Cuts.gm1, shield-F.Cu.gtl, shield-F.Mask.gts, shield-F.Paste.gtp, shield-F.SilkS.gto]
2016-03-29 gerbers to manufacturing
2016-03-29 Added part numbers and BOMs
    [pole.sch, shield.sch]
2016-04-07 thegrid2 data cable cutting list
2016-04-13 add simple fading example using PWM
2016-04-13 add DAC to drive buzzer
    [halconf.h, main.c, mcuconf.h]
2016-04-16 BOM stuff
    [bom.ods, pole.sch]
2016-04-18 tkinter colour patterns and sample colour pattern
2016-04-20 First prototype diffusion pattern
2016-06-14 Colour wheel hsv demo pattern
2016-07-23 don't beep on serial fail
    [main.c]
2016-07-24 Repsin of new shield PCB, nominal first route.
    [shield.kicad_pcb, shield.sch]
2016-07-24 Re-route of shield, DRC issues though.
    [shield.kicad_pcb, shield.sch]
2016-07-24 shield PCB ERC
    [shield.sch]
2016-07-24 Ground planes and stitching
    [shield.kicad_pcb]
2016-07-24 Shield PCB r2 nominally finished.
    [shield-B.Cu.gbl, shield-B.Mask.gbs, shield-B.SilkS.gbo, shield-F.Cu.gtl, shield-F.Mask.gts, shield-F.Paste.gtp, shield-F.SilkS.gto, shield.drl]
2016-07-29 Added parts, BOM and stickerBOM
    [shield.sch]
2016-07-31 driver fw
2016-07-31 Achievement unlocked: Shatner of the mount
2016-08-02 fix annoying sound issue
    [sound.c, soundbench.py]
2016-08-02 Now flows through patterns much more smoothly and nicely. Problems: finishes once it gets to white; doesn't go through whole rainbow
2016-08-02 Removed debug print statement
2016-08-02 trying to track down a stupid bug but i am too sleepy
2016-08-03 [cleanup 2] remove all old directories
    [haarp.skp, pole.skp]
2016-08-03 [cleanup 5] Move PCBs into hardware/
    [bom.ods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]
2016-08-03 [cleanup 7] move laser, docs, scripts into misc
    [all.dxf, both_signs_text_flattified.dxf, element14.dxf, farnell_parts.ods, guying_rings_stacked.dxf, noarduino.dxf, timing.ods, url.dxf]
2016-08-03 generate StickerBOM for driver board
2016-08-03 Looks like the bugs have indeed been solved, though only tested on a computer that could run webgl verrryy slowly. Hooray! Currently have the red runner snaking through the blue grid ad infinitum, wi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
2016-08-04 have separate idle thread so main can sleep
2016-08-04 fix up driver fw issues
    [bus.c, halconf.h, main.c]
2016-08-04 go red on checksum error
    [frame.c]
2016-08-04 Fixing up for pull request
    [bom.ods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]
2016-08-05 fix driver board power control
    [all_on.py, power.c, rgb_cycle.py, set_ids.py]
2016-08-05 change driver baud to 1M
2016-08-05 baud to 1M and PWM to 16k
2016-08-05 Fixed now playing when no pattern loaded
    [web.py]
2016-08-05 update firmware for high baud, low pwm, new frame
2016-08-05 Add power off when off
2016-08-05 Fix the weird serial.write
    [control.py, serial.py]
2016-08-05 Fix weirdness in off-ness
    [control.py]
2016-08-06 Add watchdog timer
2016-08-06 drop pwm freq to reduce error rate
    [leds.c]
2016-08-06 Added sound to annihilation pattern, now sounds like an incoming with descending pitch, and then clicks for the explosion
2016-08-07 invert rows and cols in power-cut-hack
    [control.py]
